Madaul22/Analog-Voltage-Stabilizer/Raport Proiect SCIA Madarasan.pdf

# Proiect SCIA

### Grupa : 2132

### Semigrupa : 1

### Student : Madarasan Ioan-Alexandru

# Cuprins

# 1.Tematica proiectului

### In procesarea analogica , drumul de la un semnal brut la o informatie utile este o calatorie a rafinamentului .Tematica acestui proiect vizeaza proiectarea si implementarea unui lant complet de conditionare , capabil sa transforme o unda

oscilanta intr-o tensiune stabila , optimizata pentru monitorizare si achzitie de date.

### Sistemul este construit in jurul a patru etaje , fiecare avand un rol in integritatea semnalului:

### -Pregatirea si Echilibrarea (Etajul 1) : Totul incepe cu Amplificatorul cu compensare DC . In aceasta etapa , semnalul nu este doar ridicat la un nivel

prelucrabil,ci si “curatat” de erorile de offset ,asigurand o baza de plecare simetrica si precisa pentru restul circuitului.

### -Selectia Spectrala (Etajul 2) : Semnalul trece apoi prin Filtru Trece-Banda

Rauch.Aceasta configuratie cu feedback multiplu actioneaza ca un selector riguros,

### lasand sa treaca doar banda de frecventa de interes si atenuand drastic atat zgomotul de joasa frecventa , cat si cel de inalta frecventa .Astfel, se obtine o “purificare”

spectrala necesara pentru o masuratoare corecta.

### -Adaptarea Dinamica (Etajul 3) : La etajul al treilea , sistemul capata inteliganta prin Amplificatorul cu Castig Programabil . Prin manevrarea manuala a rezistentelor de

feedback , utilizatorul poate ajusta sensibilitatea sistemului in 4 trepte cu pas de 3 dB , incepand de la 6dB pana la 15dB , oferind flexibilitate in fata unor semnale de intrare cu intensitati diverse.

### -Distilarea Finala (Etajul 4) : Drumul semnalului se incheie unde Redresorul de

precizie si Filtrul de integrare conlucreaza pentru a transforma oscilatiile purificate intr-

### o valoare medie constanta . Rezultatul este o tensiune DC liniara si perpendiculara , o

oglinda fidela a semnalului original , pregatita pentru interpretarea finala.

### Aceasta lucrare reprezinta o demonstratie a modului in care precizia matematica a simularii in LTSpice si provocarile reale ale implementarii pe breadboard converg

pentru a crea un instrument de masura fiabil.

# 2.Dimensionarea Etajelor

### 2.1.Etajul 1

### Specificatiile de proiectare a primului Etaj :

-tip sursa de semnal : sursa de tensiune ideala ; -Amplitudine minima (Vin_min) : 4.15E-01 V ;

-Amplitudine maxima(Vin_max) : 1.17E+00 V ;

-Tip etaj : Amplificator inversor cu 1 AO si compensare DC (2.1.1) ;

-Câștig liniar (|Av1
|) : 1.5;

-Amplificator operațional cerut : AD8065;

-Amplificator operațional utilizat : OP482 .

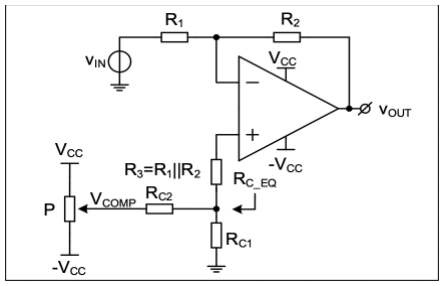
[picture p4: figure]

(2.1.1)

Realizarea calculelor:

1.Dimensionarea câștigului : Relația de transfer pentru un amplificator inversor este |Av1
| =

R2
R1

. Pentru a obține câștigul de specificat de 1.5 , alegem o

valoare standard pentru R1 care sa respecte impedanța de intrare si calculam R2 :

-Alegem R1 = 10kΩ ;

-Rezulta R2 = 1.5 ∙ R1 = 1.5 ∙ 10kΩ = 15kΩ.

2.Compensarea DC : Conform schemei de principiu , pentru a minimiza erorile de polarizare , se introduce rezistenta RC pe intrarea neinversoare :

- RC = R1

||R2 =

10kΩ∙15kΩ
10kΩ+15kΩ

= 6kΩ.

Pentru rețeaua de compensare a offset-ului , se vor alege valorile RC1

, RC2 si
potențiometrul P astfel încât curentul injectat sa poată compensa variațiile DC ale semnalului de intrare fără a afecta stabilitatea câștigului .

Pentru a asigura stabilitatea , am ales valorile de referința RC1=10kΩ si RC2 =10kΩ .

In cazul potențiometrului , am înlocuit componenta cu un divizor de tensiune realizat din 2 rezistente ambele având o valoare Rtot=10kΩ dar si un factor
poz =0.555 pentru a defini bratele divizorului:

-R3=Rtot ∙ poz = 10kΩ ∙ 0.555 = 5.55kΩ

-R4=Rtot ∙ (1-poz) = 10kΩ ∙ 0.455 = 4.45kΩ

2.2.Etajul 2

Specificațiile de proiectare pentru al doilea Etaj :

-Tip etaj : Band-pass 1 AO V-V Rauch (2.2.1);

-Câștig liniar in banda de trecere (|H0
|) : 1 ;
- Rezistenta de intrare minima (Rin_min) : 750 Ω ;

-Banda (BW) : 1000 Hz ;

-Factor de calitate (Q) : 0.707 ;

-Frecventa centrala (f0

) : Calculata cu BW ∙ Q = 707 Hz .

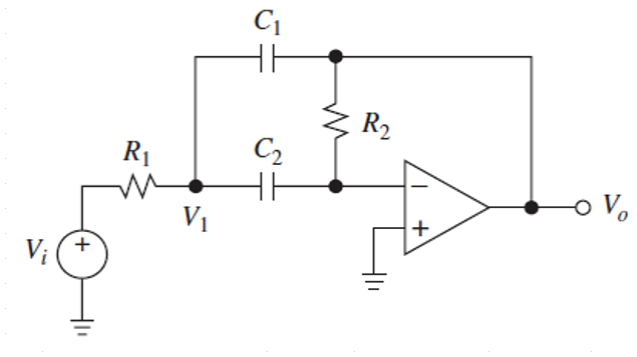
[picture p5: figure]

(2.2.1)

Realizarea calculelor :

Pentru proiectarea acestui filtru , utilizând relațiile specifice configurației Rauch (Multiple Feedback). Pentru a simplifica procesul si a asigura precizia , alegem o valoare pentru condensatoare : C1 = C2 = C = 100nF.

1.Calculul rezistentei R2

(Feedback) : Rezistenta R2 determina factorul de calitate si banda filtrului :

R2 =

Q
π∙f0∙C

=

1
π∙BW∙C

=

1
3.14∙1000∙100∙10⁻⁹ ≈ 3.18kΩ

2.Calculul rezistentei R1

(Intrare) : Rezistenta R1 seteaza castigul maxim |H0 |
la frecventa centrala :

R1 =

R2
2∙|H0|

=

3.18kΩ
2∙1

= 1.59kΩ

2.3.Etajul 3

Specificațiile de proiectare pentru al treilea Etaj:

-Tip etaj : Inversor cu switch-uri in calea de semnal , conexiune paralel;

-Câștig minim : 6 dB ;

-Câștig maxim : 15 dB ;

-Rezoluție (pas minim) : 3 dB ;

-Număr de pași : 4 (6 dB , 9 dB , 12 dB ,15dB);

-Rezistenta de intrare minima : 3kΩ .

Realizarea calculelor:

1.Alegerea rezistentei de intrare (Rg) : Pentru a respecta specificația de Rin_min alegem o valoare standard pentru Rg = 3.3kΩ .

2.Pasul de 15 dB(Câștig maxim – Switch S4 închis) : Pentru câștigul maxim , utilizam o singura rezistenta in bucla de reacție (R5
) .

Av(15dB) = 10¹⁵/20 ≈ 5.623

Recℎiv4 = Av(15dB)

- Rg = 5.623 ∙ 3.3kΩ = 18.55kΩ

Alegem R5 = 18.5kΩ

3.Pasul de 12 dB (Switch-urile S4,S3 închise) : Rezistenta echivalenta trebuie sa scadă pentru a reduce câștigul.

Av(12dB) = 10¹²/20 ≈ 3.98

Recℎiv3 = Av(12dB)

- Rg = 3.98 ∙ 3.3kΩ = 13.13kΩ

Deoarece Recℎiv3 = R5

||R4

, calculam R4
:

1
R4

=

1
13.13kΩ

−

1
18.5kΩ

⟹ R4 ≈ 45.2kΩ

Alegem o valoare standard : R4 = 47kΩ

4.Pasul de 9 dB(Switch-urile S4,S3,S2 închise) : Rezistenta echivalenta trebuie sa scadă pentru a reduce câștigul.

Av(9dB) = 10⁹/20 ≈ 2.818

Recℎiv3 = Av(9dB)

- Rg = 2.818 ∙ 3.3kΩ = 9.3kΩ

Deoarece Recℎiv2 = Recℎiv3

|| R3

,calculam R3
:

1
R3

=

1
13.13kΩ

−

1
9.3kΩ

⟹

R3 ≈ 33kΩ

Alegem o valoare standard : R3 = 33kΩ

4.Pasul de 6 dB(Switch-urile S4,S3,S2.S1 închise) : Rezistenta echivalenta trebuie sa scadă pentru a reduce câștigul.

Av(6dB) = 10⁶/20 ≈ 2

Recℎiv1 = Av(6dB)

- Rg = 2 ∙ 3.3kΩ = 6.6kΩ

Deoarece Recℎiv1 = Recℎiv2

|| R2

,calculam R2
:

1
R2

=

1
6.6kΩ

−

1
9.3kΩ

⟹ R2 ≈ 22.7kΩ

Alegem o valoare standard : R2 = 22kΩ

2.4.Etajul 4

Specificațiile de proiectare pentru al patrulea Etaj:

-Tip etaj : Redresor dublu alternanta (2.4.1) ;

-Câștig liniar (|Hv4
|) : 1 .

Realizarea calculelor si alegerea componentelor :

1.Pentru acest etaj ,s-au utilizat valorile nominale prevăzute in schema de proiectare pentru a asigura o redresare dubla alternanta simetrica si un câștig unitar.

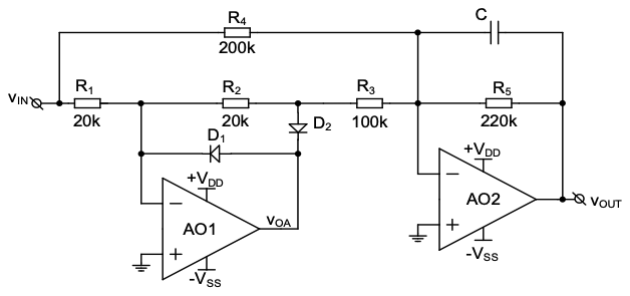
[picture p6: figure]

(2.4.1)

Lista valorilor pentru rezistente :

-R1 = 20kΩ ;

-R2 = 20kΩ ;

-R3 = 100kΩ ;

-R4 = 200kΩ ;

-R5 = 220kΩ .

2.Dimensionarea condensatorului de filtrare (C) : Aceasta este singura componenta dimensionata specific pentru a extrage valoarea medie (DC) a semnalului redresat.

S-a ales o constanta de timp τ = R · C mult mai mare decât perioada semnalului de intrare (T = 10 ms pentru 100Hz) .

Am ales valoarea condensatorului de C = 1µF . Împreuna cu rezistenta de feedback de 220kΩ , aceasta asigura o netezire eficienta , rezultând o tensiune continua stabila de aproximativ 700-900 mV la ieșire.

## 3.Caracterizarea Etajelor

In cadrul parții de simulare a proiectului am utilizat programul de simulare LTspice . In acest program am realizat toate schemele electrice si pofilele de simulare pentru fiecare dintre etaje .

3.1.Etajul 1

Pornind de la schema de principiu primita in specificații , am realizat aceasta schema :

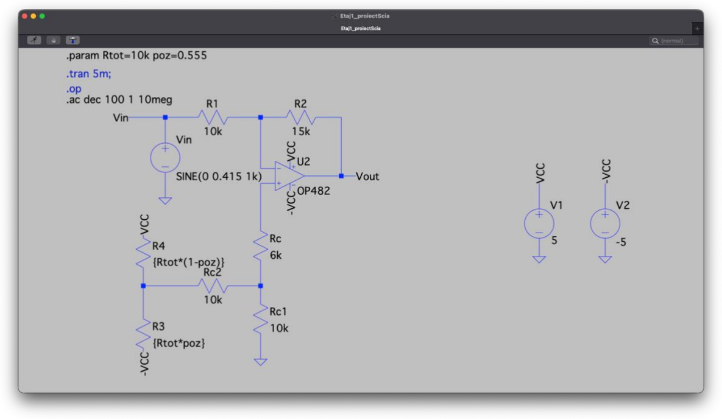
[picture p7: figure]

In cadrul aceste scheme putem observa următoarele lucruri:

-secvența „.param Rtot =10k poz=0.555” semnifica instantierea in programul de simulare a parametrilor „Rtot” si „poz” care sunt necesari pentru realizarea divizorului de tensiune pentru compensarea DC a circuitului ;

-secvența „.op” semnifica o simulare de tip DCOP pentru afișarea punctului static de funcționare a circuitului ;

-secvența „.tran 5m” semnifica o simulare de tip Transient cu ajutorul căreia v-om putea măsura Slew-Rate-ul amplificatorului , cat si sa demonstram liniaritate si compensarea DC ;

-secvența „.ac dec 100 1 10meg” semnifica o simulare tip .AC cu ajutorul căreia v-om putea analiza castigul la joasa freceventa cat si banda de frecventa .

Primul profil de simulare pe care il v-om aborda este cel de tip DCOP . In imaginea de mai jos putem vedea fereasta care se poate acesa dupa rularea simularii de tip „.op”.

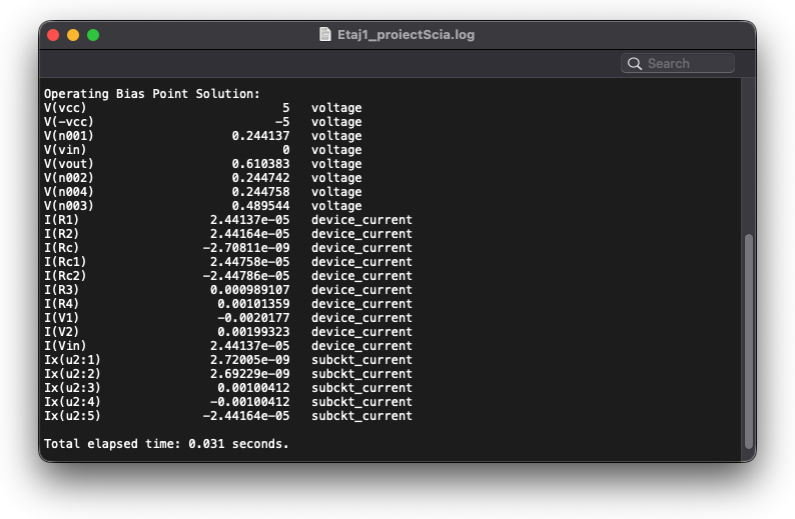
[picture p8: figure]

In cadrul imagini de mai sus putem identifica următoarele valori , pentru determinarea punctului static de funcționare cat si compensarea DC ,precum :

-V(vout) = 610mV , aceasta fiind Tensiunea de ieșire in repaus. Aceasta nu este 0 deoarece reflecta tensiunea de offset injectata prin rețeaua de compensare de la intrarea neinversoare;

-Curenții de polarizare prin ramurile rezistive :

-I(R1
) =24.41µA , curentul care trece prin rezistenta de intrare când Vin este la masa;

-I(R2
)=24.41µA , curentul prin rezistenta de feedback. Faptul ca acești doi curenți sunt identici confirma ca AO , nu „pierde” curent prin intrările sale , prezentând un caracter ideal.

Al doilea profil de simulare este cel de Analiza in frecventa(AC Analysis) care ne arata performantele etajului de amplificare si compensare DC , demonstrând o lățime de banda considerabila , mult peste frecventa semnalului util.

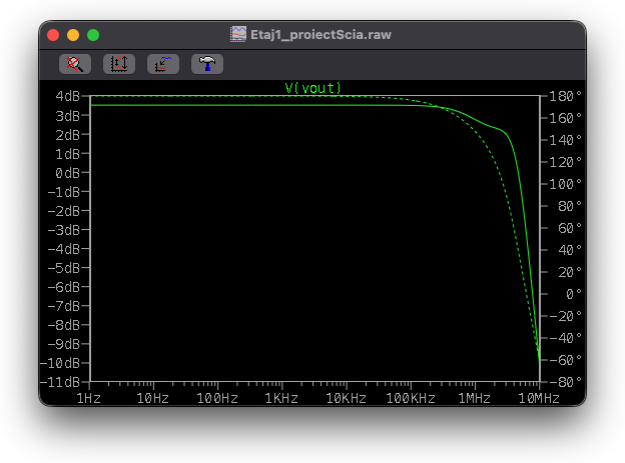
[picture p9: figure]

Câștigul de banda se observa s pe graficul de mai sus , o linie orizontala constanta la valoarea de 3.52 dB . Aceasta corespunde exact câștigului liniar calculat de 1.5 (20log(1.5)≈ 3.522 dB) , validând corectitudinea dimensionării rezistentelor R1 si R2

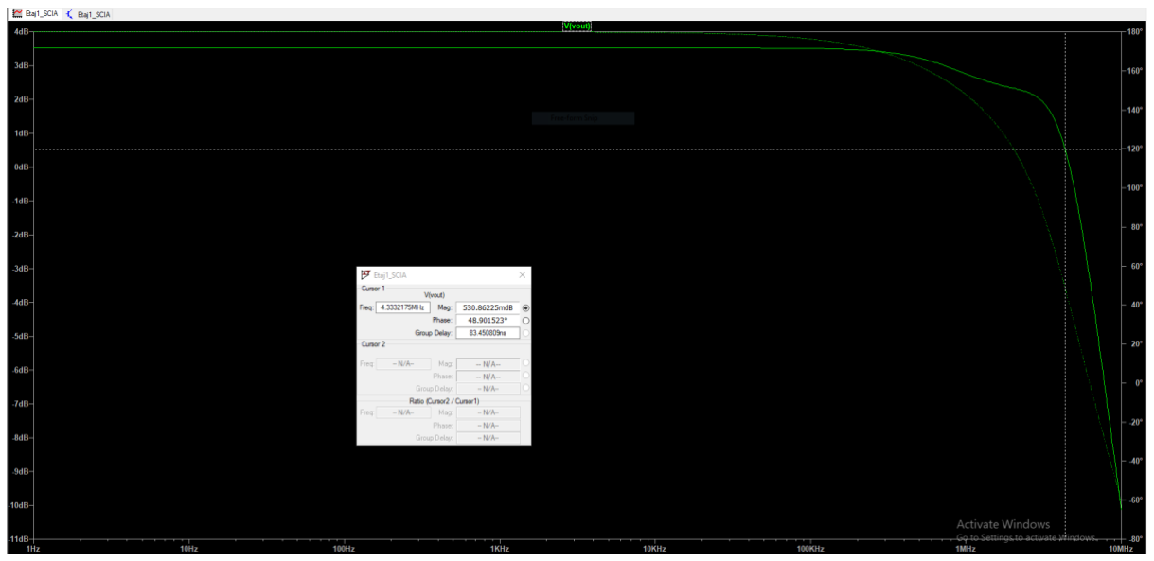
[picture p10: figure]

In cadrul lățimii de banda se poate observa frecventa de taiere la -3dB se situează in jurul valorii de 4.3MHz. Acest rezultat garantează ca etajul 1 procesează fără nicio atenuare sau defazaj suplimentar in banda filtrului de la etajul următor, asigurând integritatea semnalului pentru etajele următoare.

Al treilea si ultimul profil de simulare al acestui etaj este cel Transient ,in care v-om analiza compensarea DC, cat si v-om studia liniaritatea.

Spre deosebire de intrare , care este centrata la 0V , semnalul de ieșire este translatat pe verticala . Se observa ca valorile de vârf ale ieșirii sunt aproximativ la +1.23V si 0V . Media semnalului (offset-ul DC) este situata la aproximativ 0.61V , valoarea care corespunde exact rezultatului simulării „.op”.

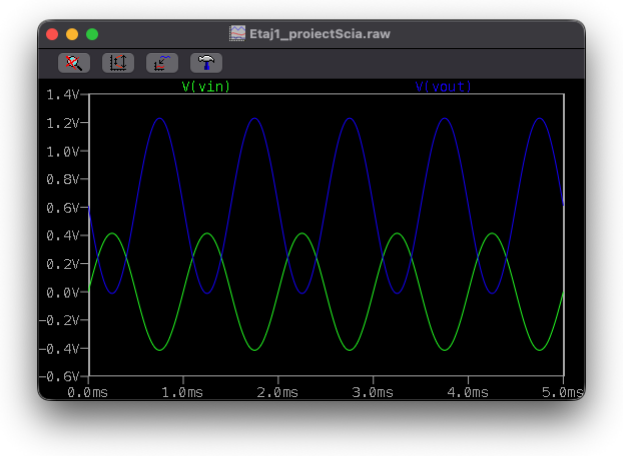
[picture p11: figure]

In imaginea de mai jos sa poate observa Slew-Rate-ul circuitului:

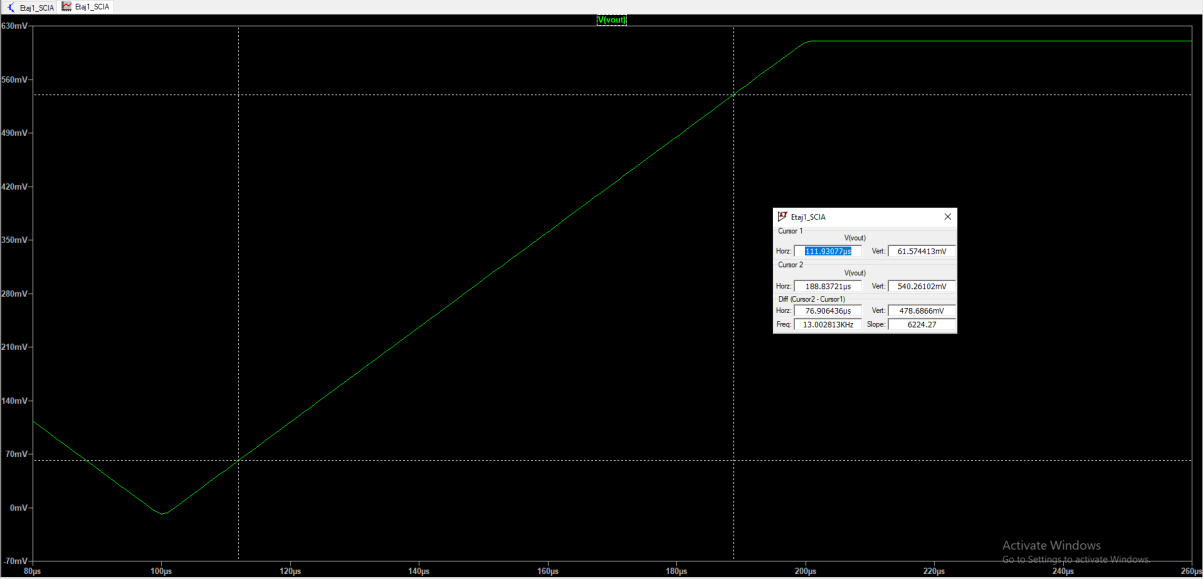
[picture p12: figure]

3.2. Etajul 2

Pornind de la schema de principiu primita in specificații , am realizat aceasta schema :

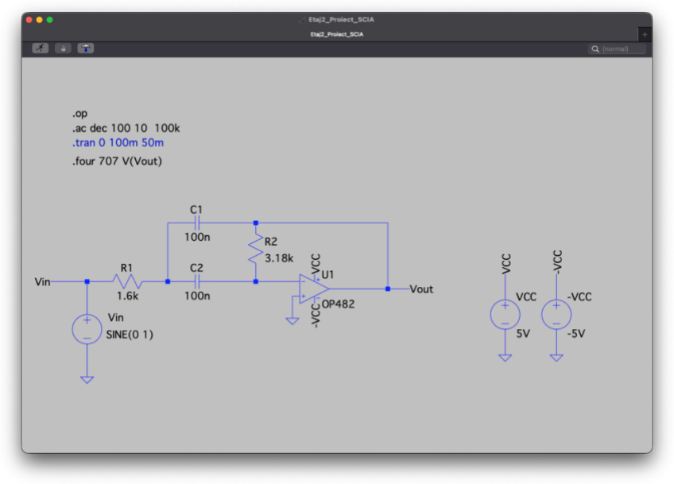
[picture p13: figure]

In cadrul acestei scheme putem observa următoarele lucruri :

-secvența „.op” semnifica o simulare de tip DCOP pentru afișarea punctului static de funcționare a circuitului ;

-secvența „.ac dec 100 10 100k” semnifica o simulare tip .AC cu ajutorul căreia v-om putea analiza câștigul la joasa frecventa cat si banda de frecventa .

-secvențele „.tran 0 100m 50m” si „.four 707 V(Vout)” , unde secventa .tran are rol de simulare principala iar .four este o analiza Fourier care ne arata valorea TDH-ului pentru filtrul Trece-Banda Rauch .

Primul profil de simulare pe care il v-om aborda este cel de tip DCOP . In imaginea de mai jos putem vedea fereasta care se poate accesa dupa rularea simularii de tip „.op”.

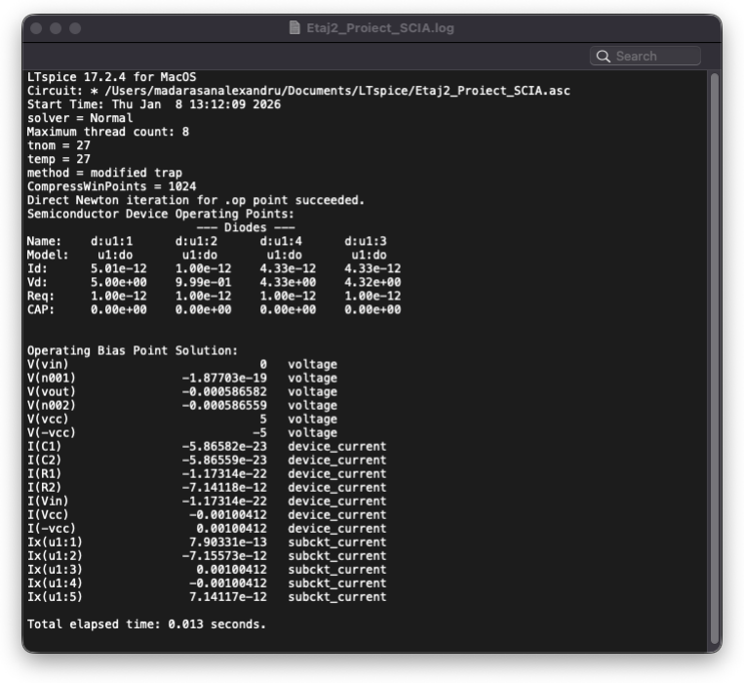
[picture p14: figure]

In cadrul imagini de mai sus putem identifica următoarele valori , pentru determinarea punctului static de funcționare :

-tensiunea de iesire in repaus (VOut2
) : Valoare este de aproximativ 1.81nV (aproape de 0V);

-curentii prin condensatoare ( I(C1) , I(C2) ) : Valorile sunt de ordinul 10⁻²⁰A;

Al doilea profil de simulare pe care il v-om aborda este cel de Analiza in frecventa . In imaginea de mai jos putem vedea graficul rezultat simulari noastre si putem analiza urmatoarele aspecte :

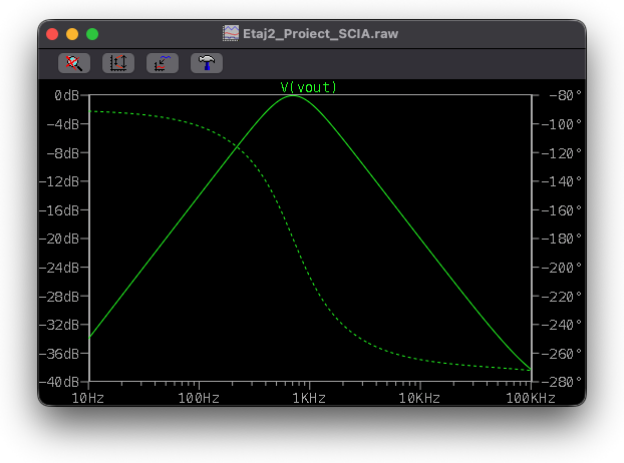
[picture p15: figure]

-din analiza graficului de magnitudine ( curba continua ) , se observa ca valoarea maxima a câștigului se obține la frecventa de rezonanta;

-valoarea măsurata a câștigului in banda este de 0 dB , ceea ce corespunde unui raport liniar de 1 . Aceasta valoare confirma ca etajul de filtrare asigura transferul semnalului util către etajul următor fără atenuări excesive care ar putea degrada raportul semnal-zgomot.

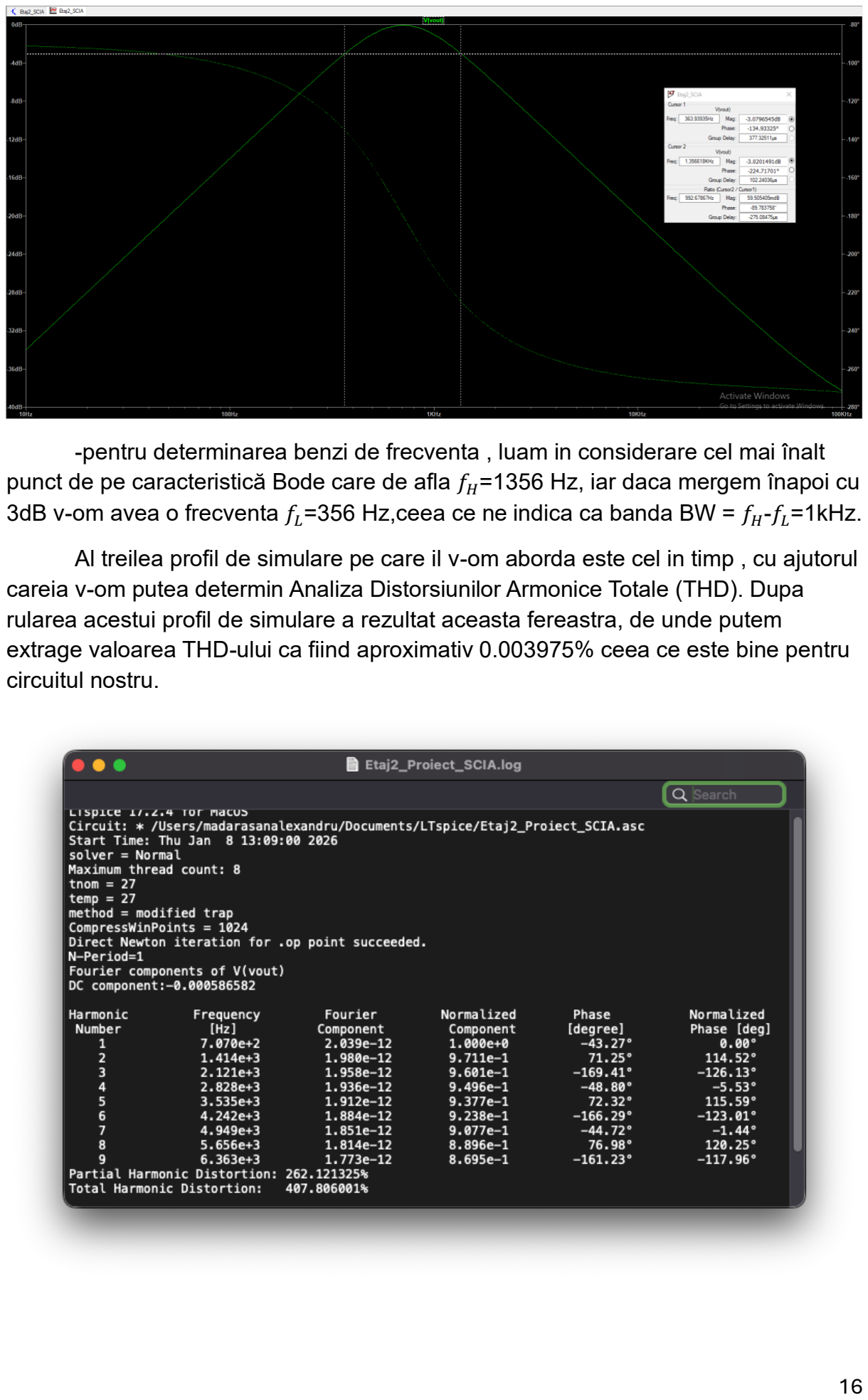
[picture p16: page 16]

-pentru determinarea benzi de frecventa , luam in considerare cel mai înalt punct de pe caracteristică Bode care de afla fH=1356 Hz, iar daca mergem înapoi cu 3dB v-om avea o frecventa fL=356 Hz,ceea ce ne indica ca banda BW = fH-fL=1kHz.

Al treilea profil de simulare pe care il v-om aborda este cel in timp , cu ajutorul careia v-om putea determin Analiza Distorsiunilor Armonice Totale (THD). Dupa rularea acestui profil de simulare a rezultat aceasta fereastra, de unde putem extrage valoarea THD-ului ca fiind aproximativ 0.003975% ceea ce este bine pentru circuitul nostru.

3.3.Etajul 3

Pornind de la schema de principiu primita in specificații , am realizat aceasta schema :

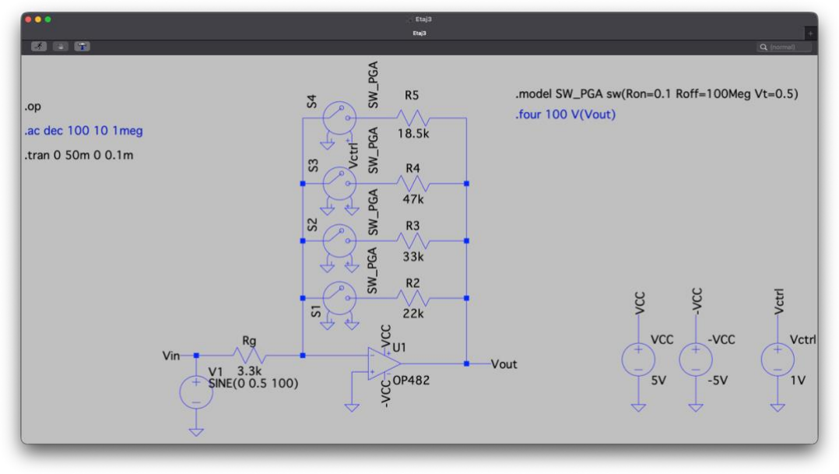
[picture p17: figure]

In cadrul aceste scheme , putem sa analizam cate va lucruri:

-secvența „.op” care este specifica unui profil de simulare DCOP , cu ajutorul căreia v-om putea determina punctul static de funcționare ( PSF );

-secvența „.ac dec 100 10 1meg” care reprezintă profil de simulare pentru Analiza in frecventa , cu ajutorul căreia v-om putea arata câștigul pe fiecare treapta cat si banda acestora ;

-secvențele „.tran 0 50m 0 0.1m” si „.four 100 V(Vout)” ambele fac parte pentru simulare in timp cu ajutorul căreia v-om putea determina THD-ul circuitului atât pentru câștig maxim (15dB) cat si la câștig minim (6dB).

Primul profil de simulare pe care ii v-om aborda este cel de tip DCOP . In imaginea de mai jos putem vedea fereastra care se poate accesa după rularea simulării de tip „.op”.

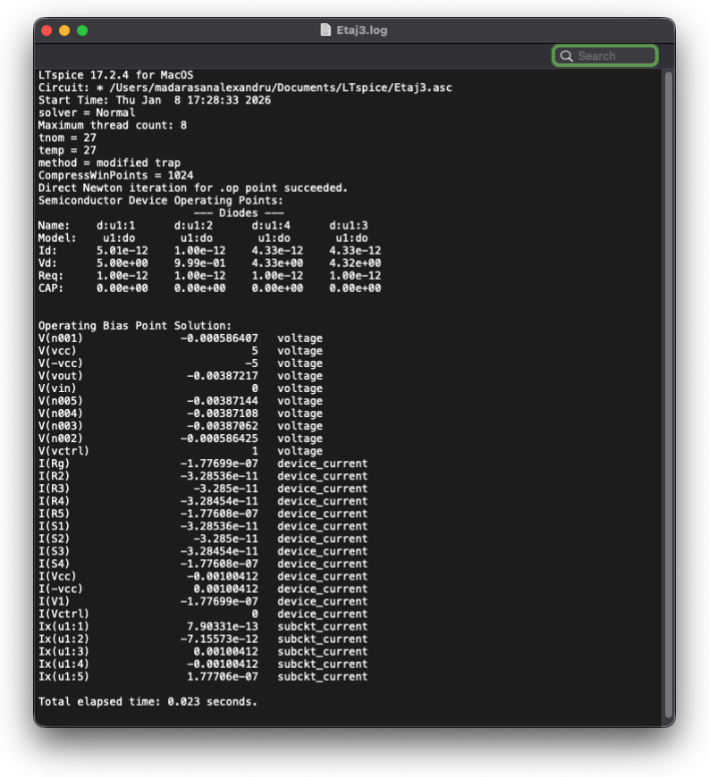
[picture p18: figure]

In cadrul imagini de mai sus putem identifica următoarele valori , pentru determinarea punctului static de funcționare :

-tensiunea de iesire in repaus (VOut2
) : Valoare este de aproximativ 1.81nV (aproape de 0V);

Al doilea profil de simulare pe care il v-om aborda este cel de Analiza in frecventa , prin acest profil de simulare o sa putem analiza castigul fiecarei trepte:

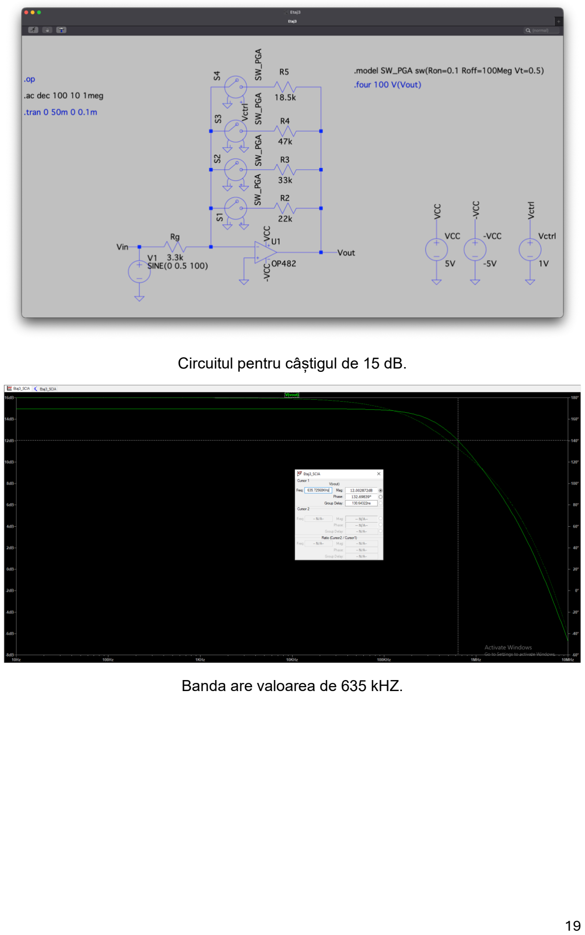
[picture p19: page 19]

Circuitul pentru câștigul de 15 dB.

Banda are valoarea de 635 kHZ.

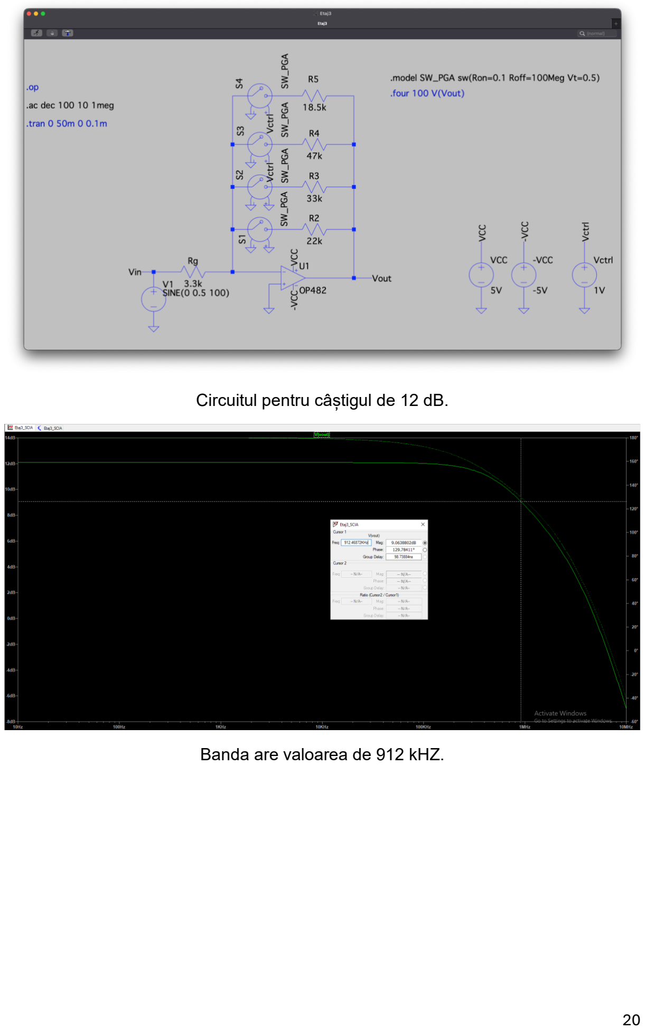
[picture p20: page 20]

Circuitul pentru câștigul de 12 dB.

Banda are valoarea de 912 kHZ.

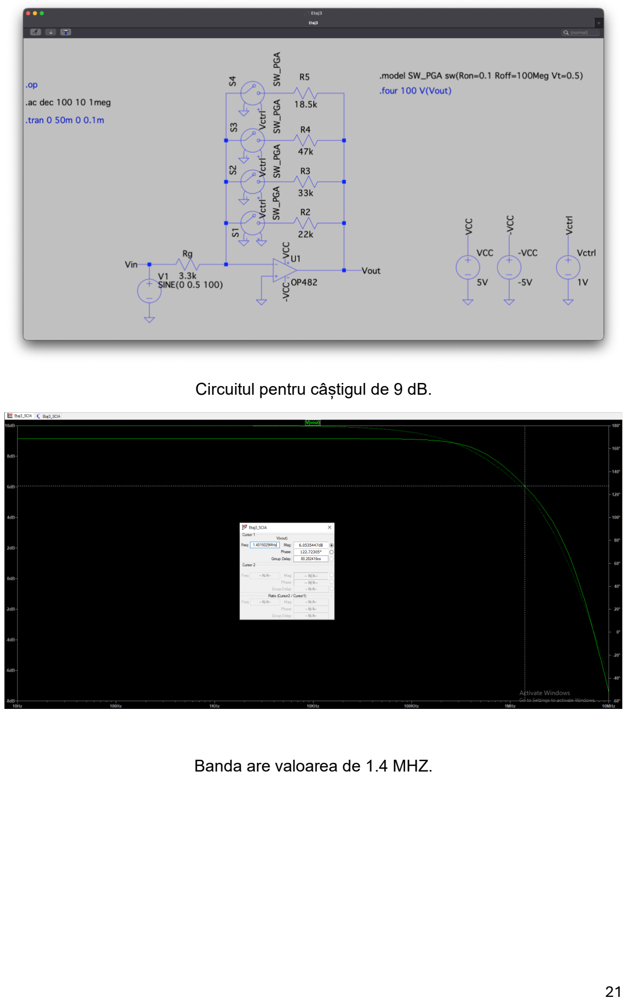
[picture p21: page 21]

Circuitul pentru câștigul de 9 dB.

Banda are valoarea de 1.4 MHZ.

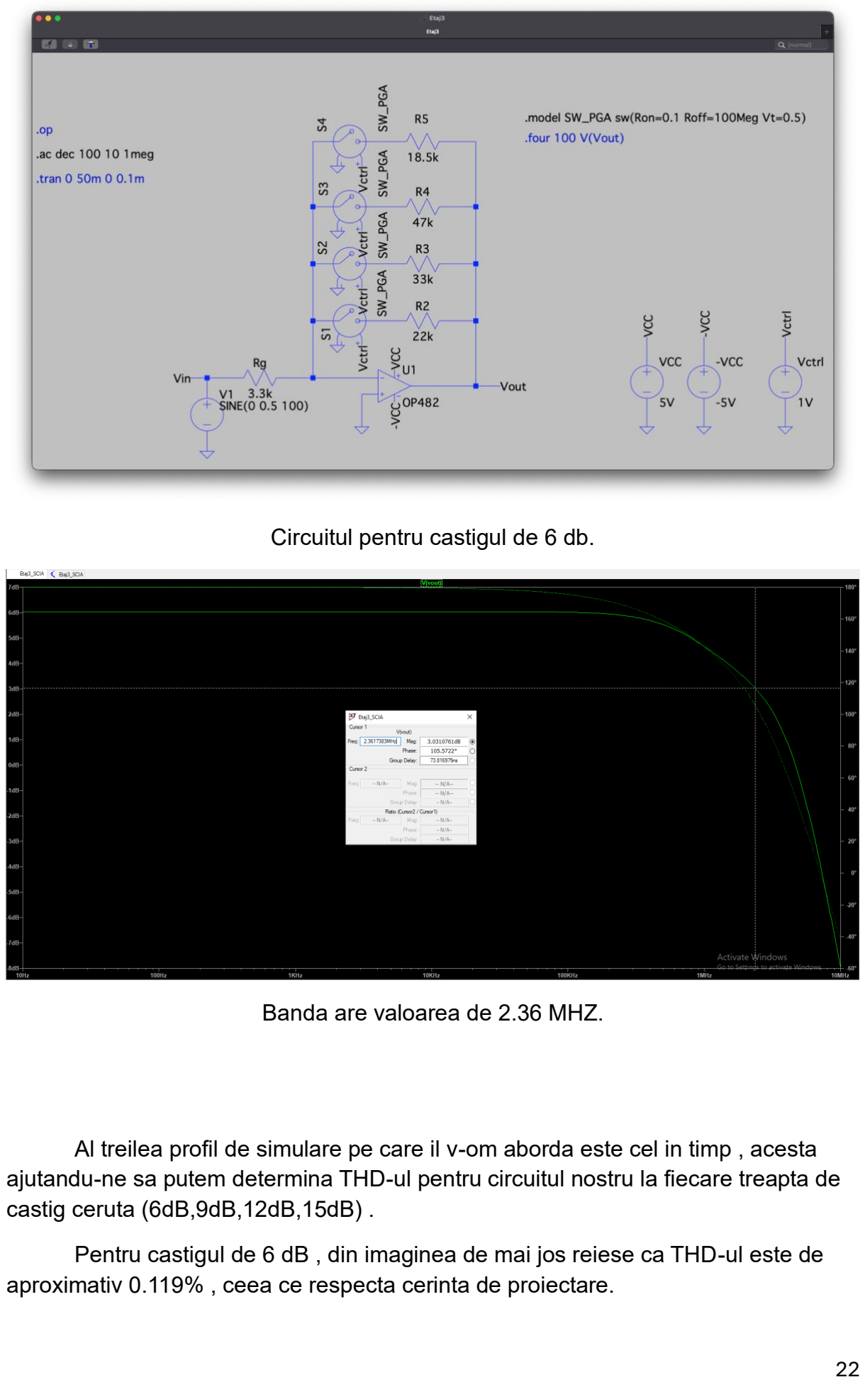
[picture p22: page 22]

Circuitul pentru castigul de 6 db.

Banda are valoarea de 2.36 MHZ.

Al treilea profil de simulare pe care il v-om aborda este cel in timp , acesta ajutandu-ne sa putem determina THD-ul pentru circuitul nostru la fiecare treapta de castig ceruta (6dB,9dB,12dB,15dB) .

Pentru castigul de 6 dB , din imaginea de mai jos reiese ca THD-ul este de aproximativ 0.119% , ceea ce respecta cerinta de proiectare.

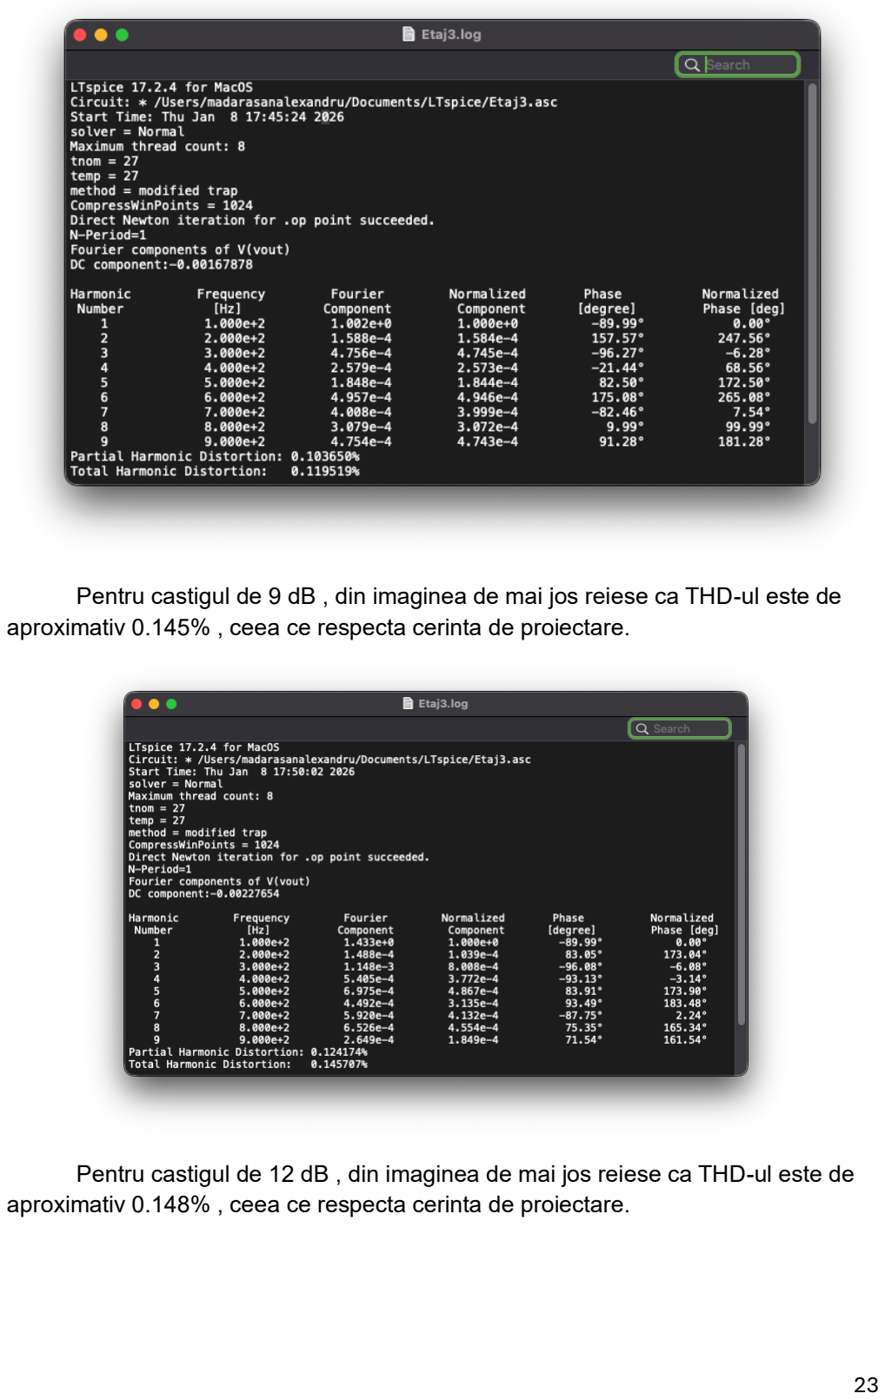
[picture p23: page 23]

Pentru castigul de 9 dB , din imaginea de mai jos reiese ca THD-ul este de aproximativ 0.145% , ceea ce respecta cerinta de proiectare.

Pentru castigul de 12 dB , din imaginea de mai jos reiese ca THD-ul este de aproximativ 0.148% , ceea ce respecta cerinta de proiectare.

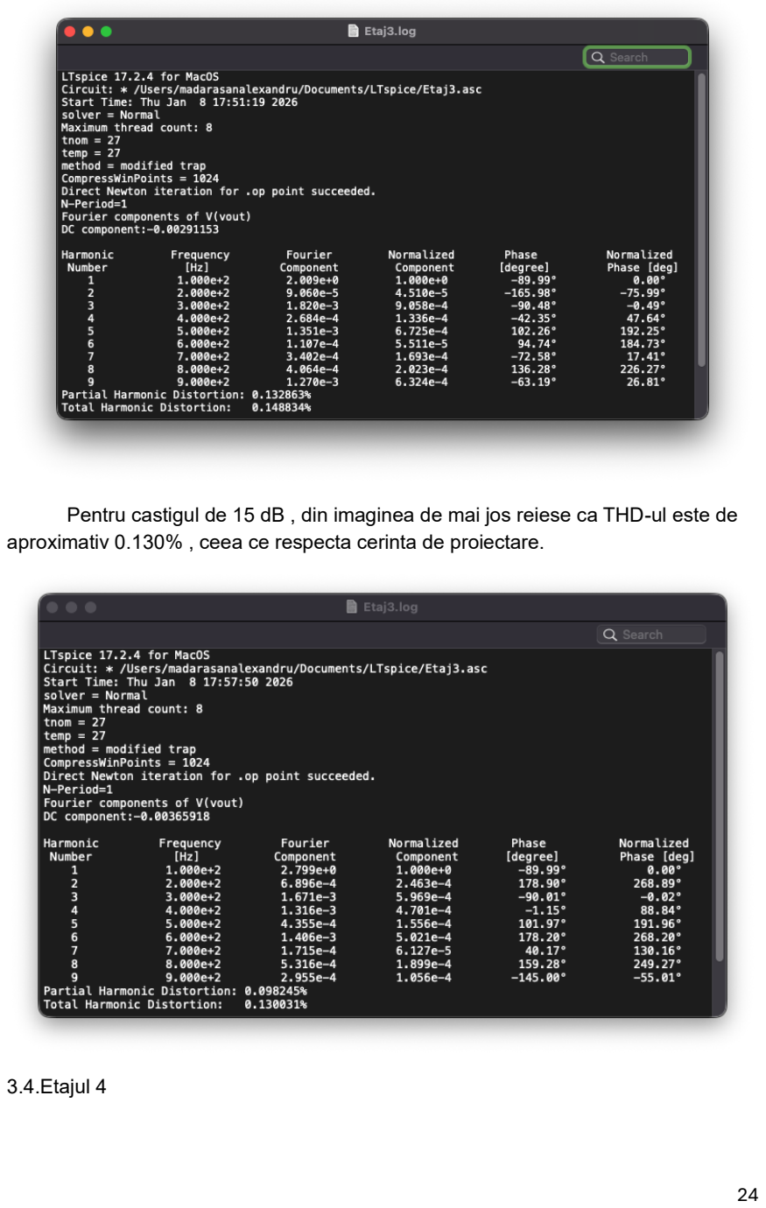
[picture p24: page 24]

Pentru castigul de 15 dB , din imaginea de mai jos reiese ca THD-ul este de aproximativ 0.130% , ceea ce respecta cerinta de proiectare.

3.4.Etajul 4

Pornind de la schema de principiu primita in specificații , am realizat aceasta schema :

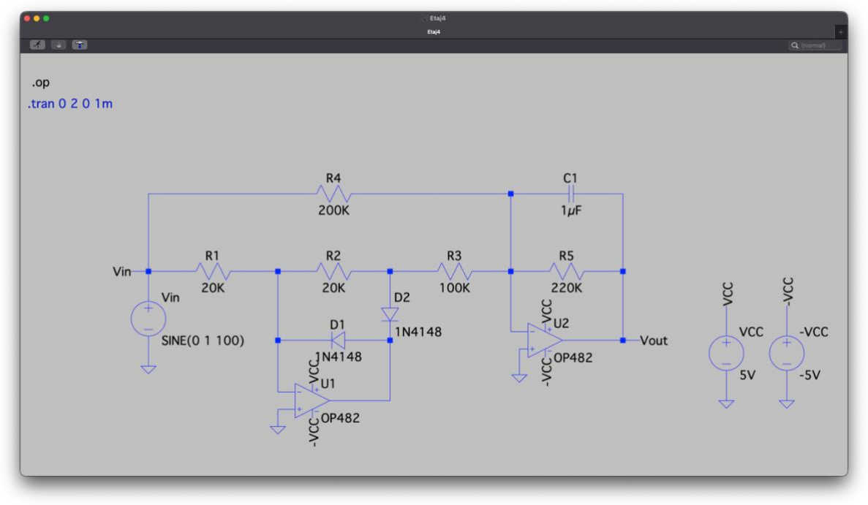
[picture p25: figure]

In cadrul aceste scheme , putem sa analizam cate va lucruri:

-secvența „.op” care este specifica unui profil de simulare DCOP , cu ajutorul căreia v-om putea determina punctul static de funcționare ( PSF );

-secvența „.tran 0 2 0 1m” care este specifica unu profil de simulare in timp , cu ajutorul căreia v-om putea arata domeniul de funcționare cat si implementarea funcției de circuit ;

In următorul circuit au fost făcute anumite modificări pentru a putea realiza profil de simulare DC Sweep , cu ajutorul căreia v-om putea vizualiza câștigul circuitului.

In cadrul acestei imagini se poate observa secvența „.dc Vin -2 2 0.01”.

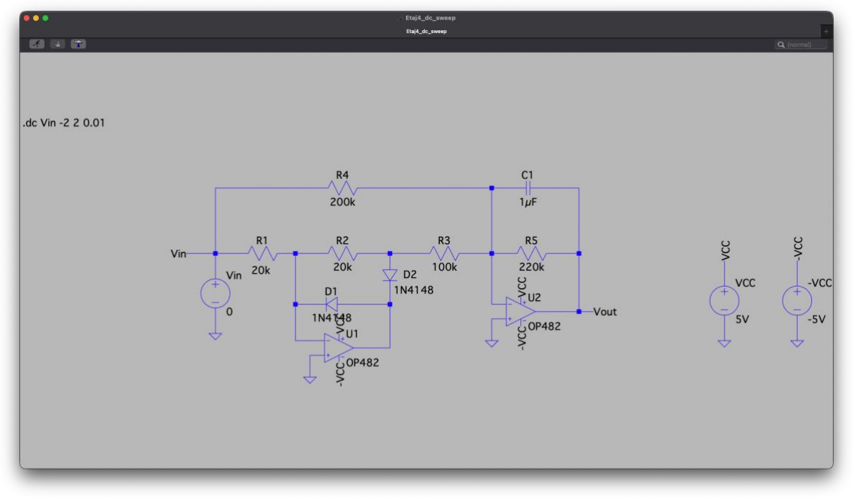
[picture p26: figure]

Primul profil de simulare pe care ii v-om aborda este cel de tip DCOP . In imaginea de mai jos putem vedea fereastra care se poate accesa după rularea simulării de tip „.op”.(3.4.1)

In cadrul imagini de mai jos putem identifica următoarele valori , pentru determinarea punctului static de funcționare :

-tensiunea de ieșire in repaus (VOut2
) : Valoare este de aproximativ 1.81nV (aproape de 0V);

-curenții prin condensatoare ( I(C1) ) : Valorile sunt de ordinul 10⁻²⁰A;

Al doilea profil de simulare pe il v-om aborda este de de tip DC Sweep . In imaginea de mai jos putem oberva evolutia castigului , realizand o forma de „V” specifica acestui redresor.

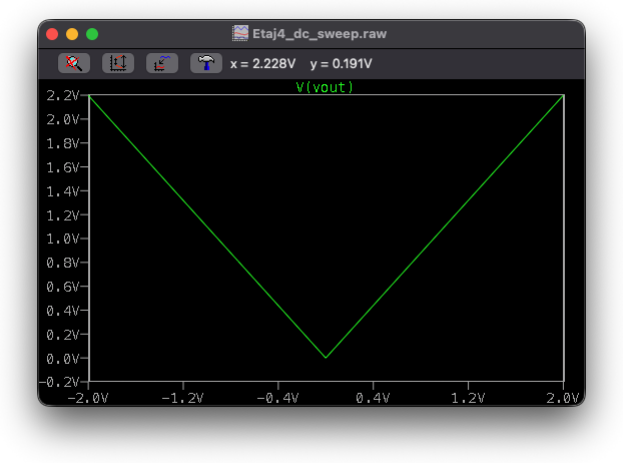
[picture p27: figure]

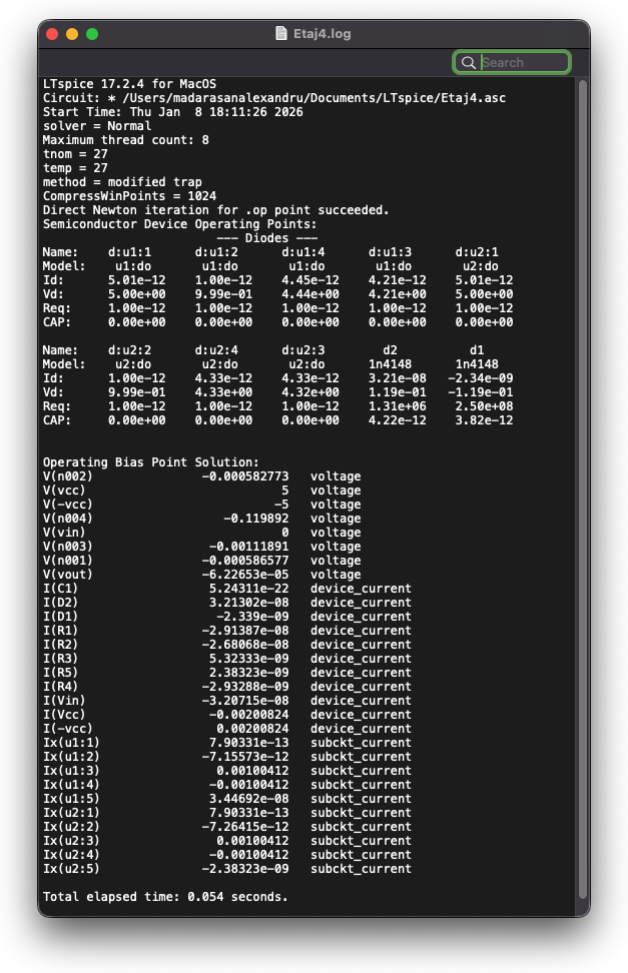
[picture p28: figure]

(3.4.1)

Al treilea profil de simulare pe care il v-om aborda este cel in timp , acesta ne v-a ajuta sa verificam daca cirucuitul de redresare isi face treaba si la iesire vedem cum vedem un semnal care la final de stabilizeaza si devine un semnal DC din sinusul aplicat la intrare din etajele anterioare.

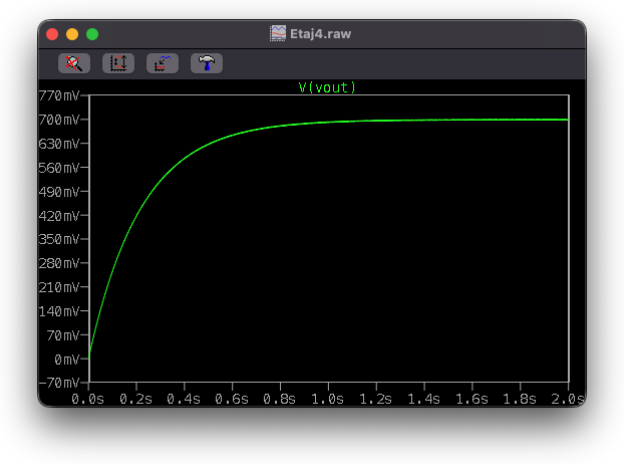
[picture p29: figure]

# 4.Verificarea si caracterizarea interfetei analogice

In cadrul acestui capitol o sa facem tranziția de la un domeniu ideal(simulări) la un domeniu real (circuite realizate pe breadboard) , unde o sa observam ca fata de simulări o sa întâmpinam mici diferențe .

4.1.Etajul 1

In cadrul acestui etaj am realizat circuitul pe breadboard , cu ajutorul componentelor puse la dispoziție de către facultate , in cele din urma am conectat cu succes dispozitivul ADALM2000 iar împreuna cu programul dedicat acestuia numit Scopy , am reușit sa realizeze măsurătorile cerute pentru acest etaj așa cum se poate vedea si in capturile de ecran .

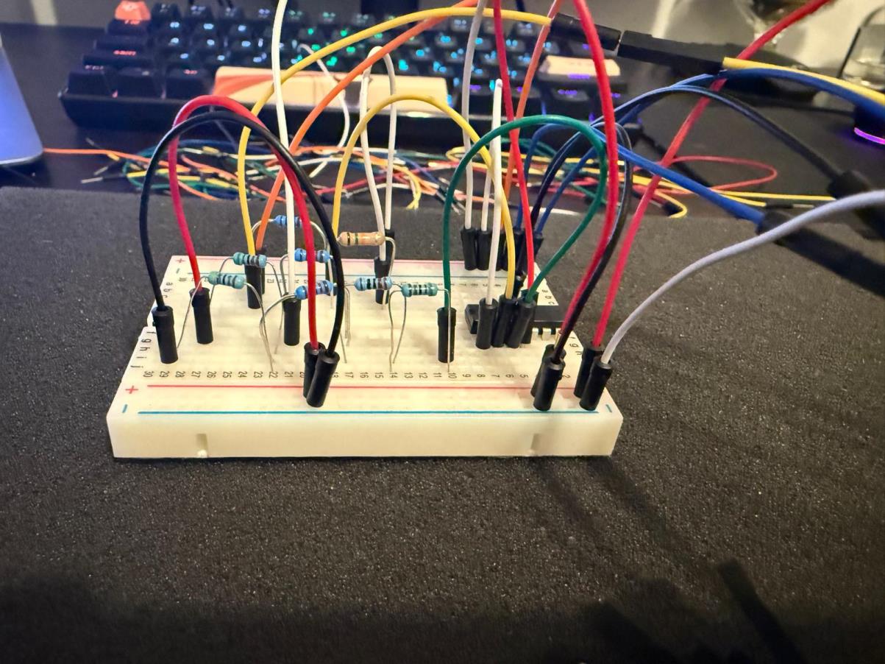
[picture p30: figure]

Circuitul fizic pentru Etajul 1

In cadrul masuratorilor am realizat masurarea Slew-Rate-ului amplificatorului utilizat , asa cum se poate vedea in imagine urmatoare:

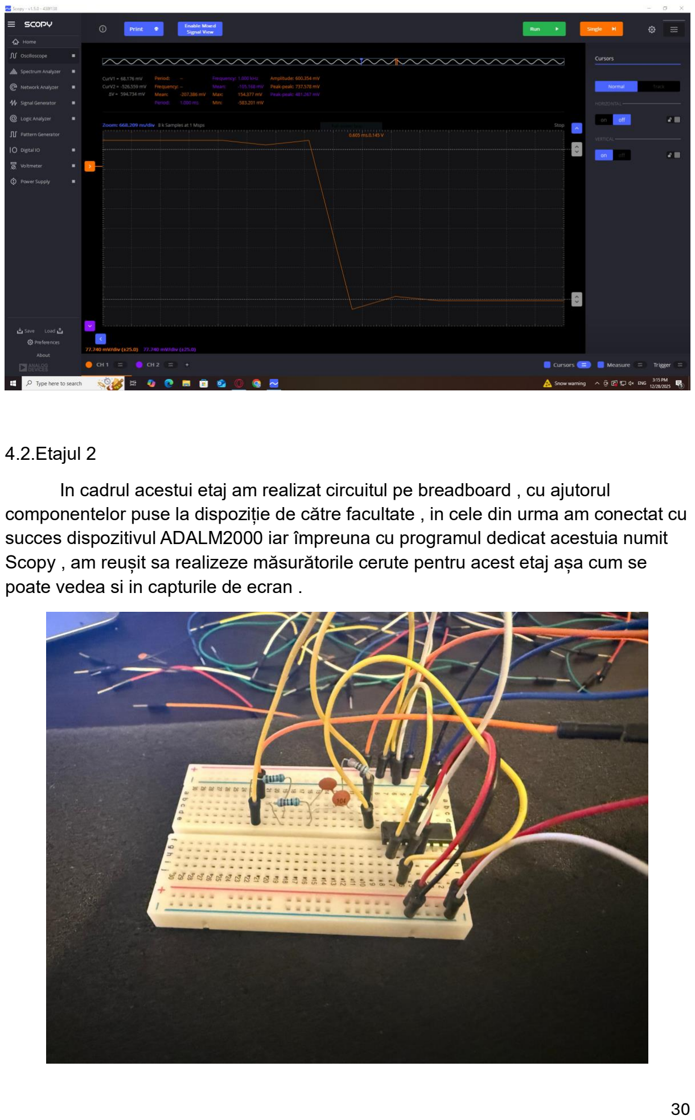
[picture p31: page 30]

4.2.Etajul 2

In cadrul acestui etaj am realizat circuitul pe breadboard , cu ajutorul componentelor puse la dispoziție de către facultate , in cele din urma am conectat cu succes dispozitivul ADALM2000 iar împreuna cu programul dedicat acestuia numit Scopy , am reușit sa realizeze măsurătorile cerute pentru acest etaj așa cum se poate vedea si in capturile de ecran .

In ceea ce priveste partea de masuratori fizice , pentru acest etaj de filtrare am realizat masurarea castigului cat si masurarea benzii de trecere .

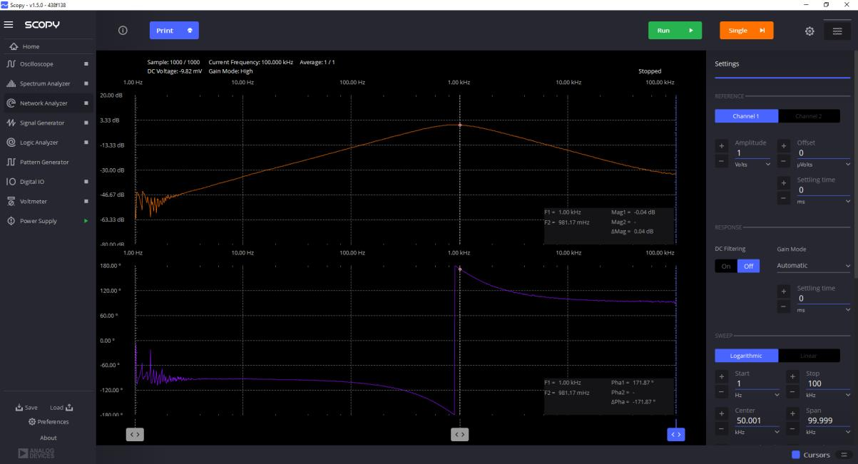
[picture p32: figure]

Imagine din programul Scopy pentru măsurarea câștigului care este 0 dB, ce corespunde in liniaritate cu câștigul de 1 din specificații.

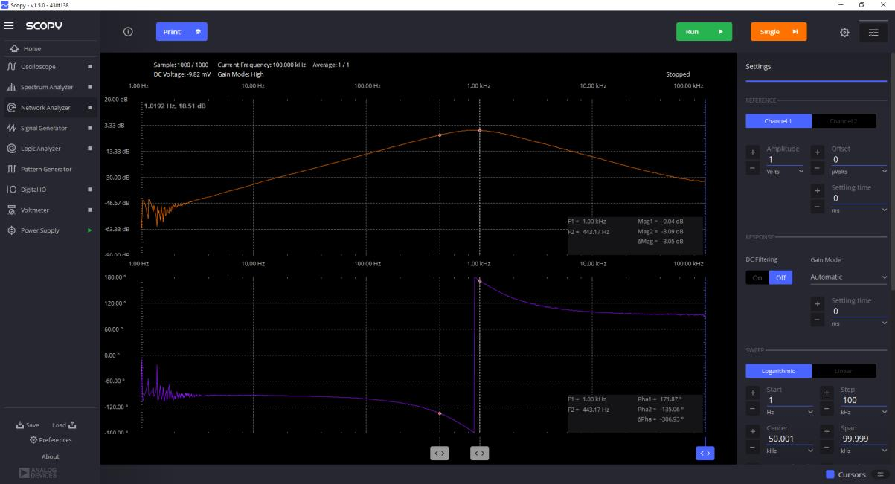
[picture p33: figure]

In imaginea anterioara extrasa din programul Scopi , se poate observa procesul de masurare a benzii de transfer cu ajutor celor 2 cursoare care unu este positionat pe varful „clopotului” iar celalat este pozitionat la -3 dB fata de pozitia din varf. Banda masurata este conform celor din specificatii.

4.3.Etajul 3

In cadrul acestui etaj am realizat circuitul pe breadboard , cu ajutorul componentelor puse la dispoziție de către facultate , in cele din urma am conectat cu succes dispozitivul ADALM2000 iar împreuna cu programul dedicat acestuia numit Scopy , am reușit sa realizeze măsurătorile cerute pentru acest etaj așa cum se poate vedea si in capturile de ecran .

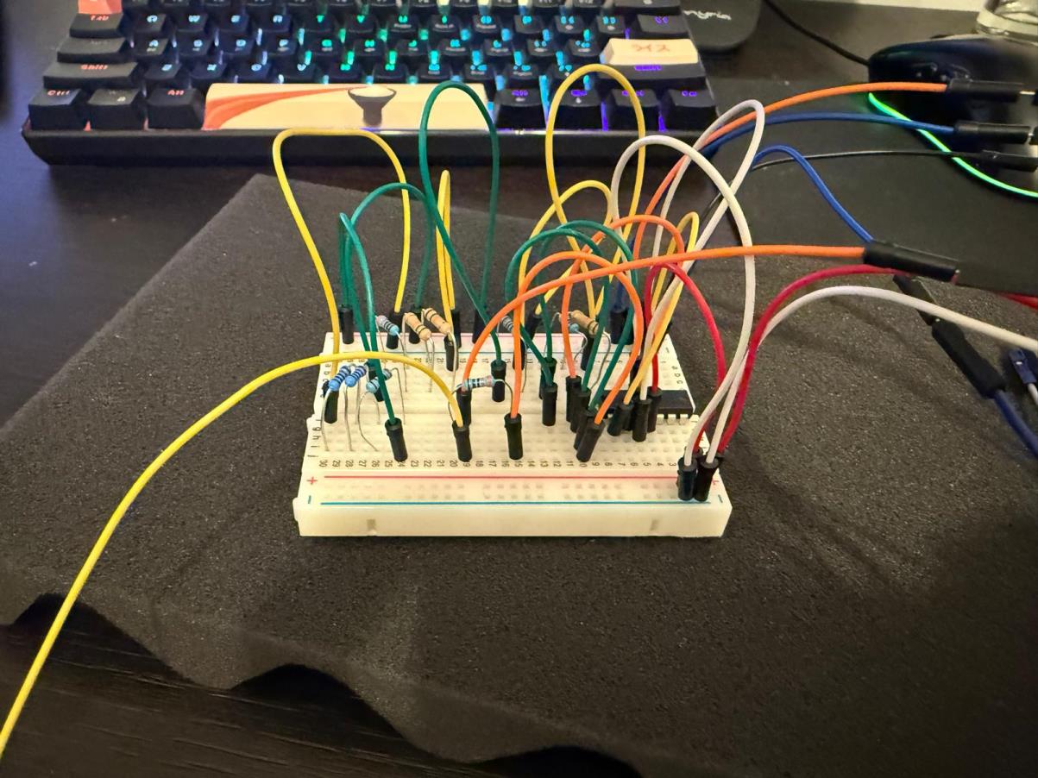
[picture p34: figure]

In cadrul acestui etaj am realizat măsurarea câștigului si măsurarea benzii de trecere pentru fiecare treapta a circuitului (6dB,9dB,12dB,15dB).

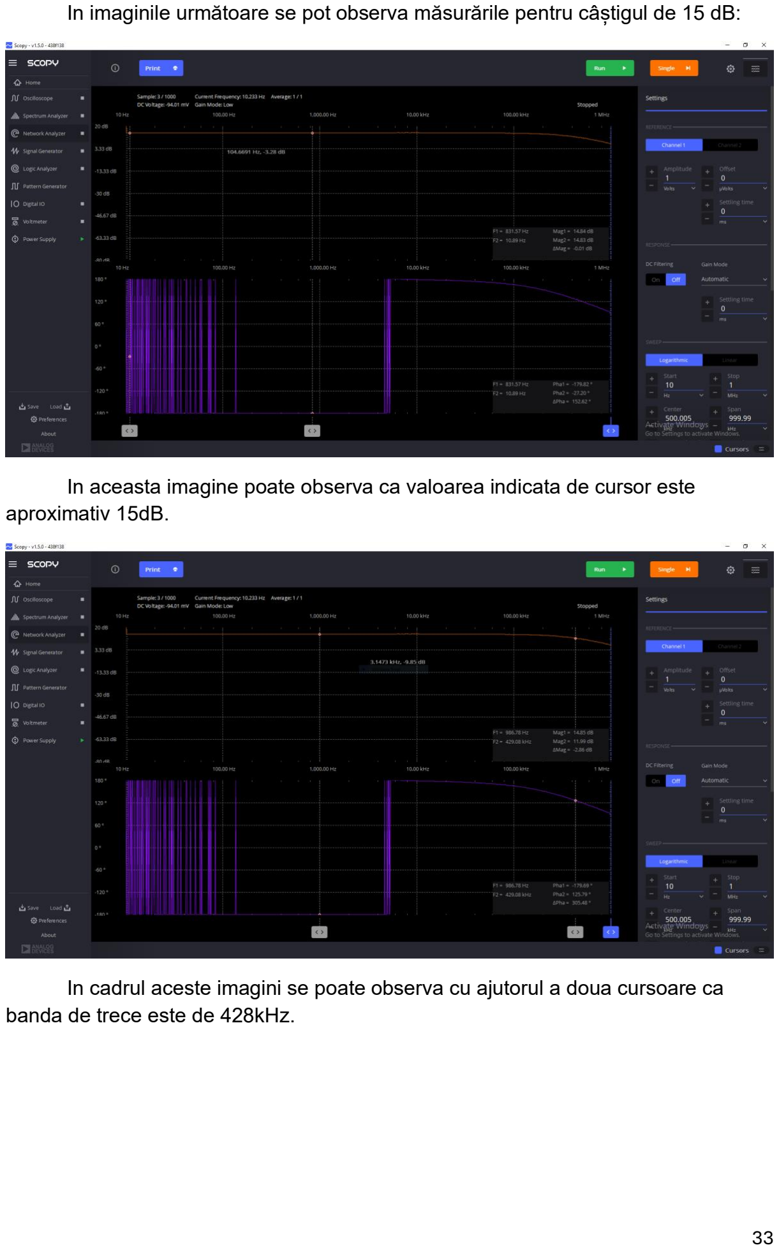
[picture p35: page 33]

In imaginile următoare se pot observa măsurările pentru câștigul de 15 dB:

In aceasta imagine poate observa ca valoarea indicata de cursor este aproximativ 15dB.

In cadrul aceste imagini se poate observa cu ajutorul a doua cursoare ca banda de trece este de 428kHz.

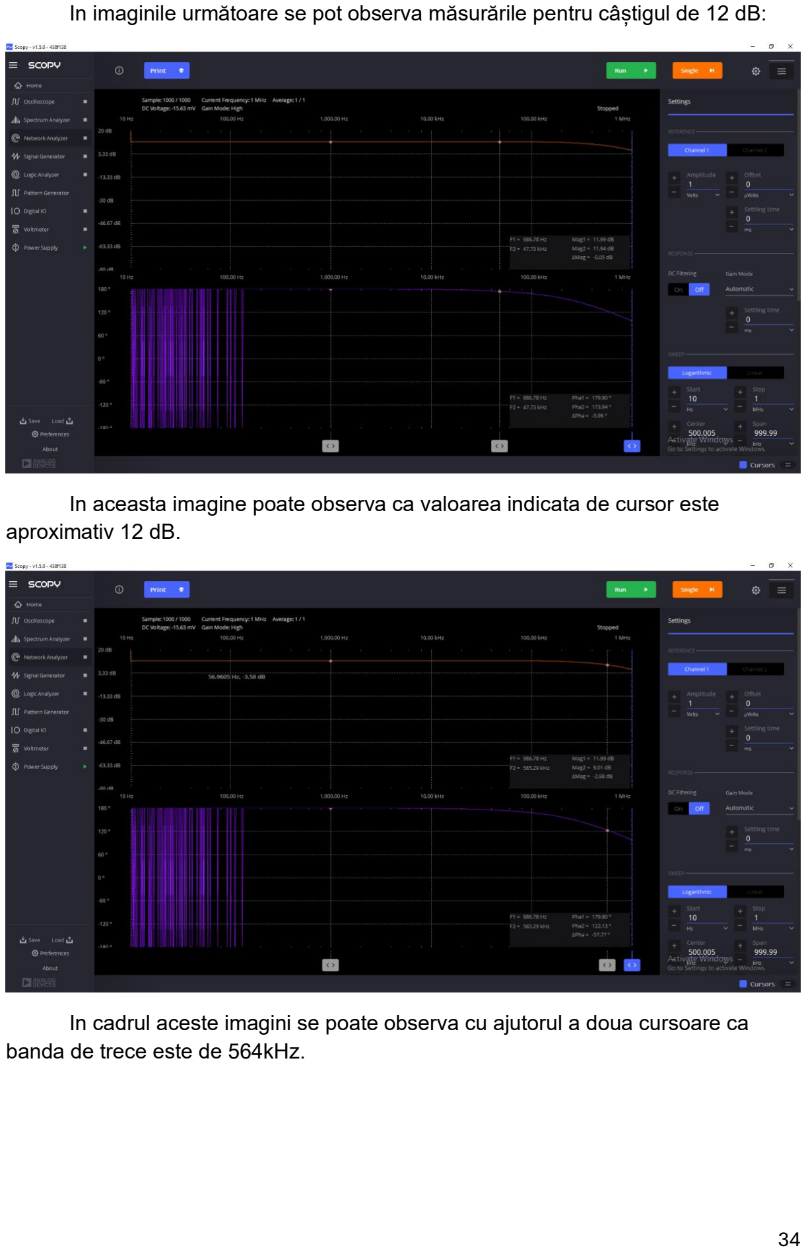
[picture p36: page 34]

In imaginile următoare se pot observa măsurările pentru câștigul de 12 dB:

In aceasta imagine poate observa ca valoarea indicata de cursor este aproximativ 12 dB.

In cadrul aceste imagini se poate observa cu ajutorul a doua cursoare ca banda de trece este de 564kHz.

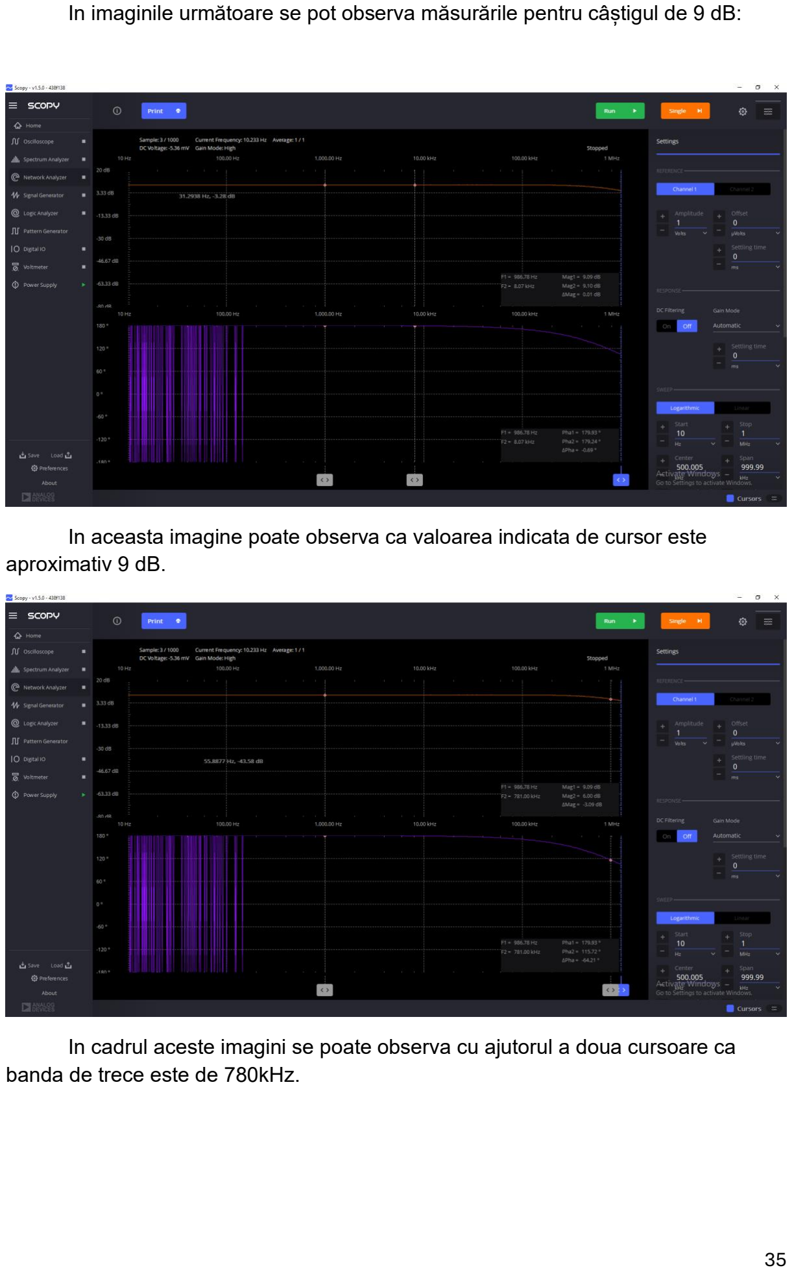
[picture p37: page 35]

In imaginile următoare se pot observa măsurările pentru câștigul de 9 dB:

In aceasta imagine poate observa ca valoarea indicata de cursor este aproximativ 9 dB.

In cadrul aceste imagini se poate observa cu ajutorul a doua cursoare ca banda de trece este de 780kHz.

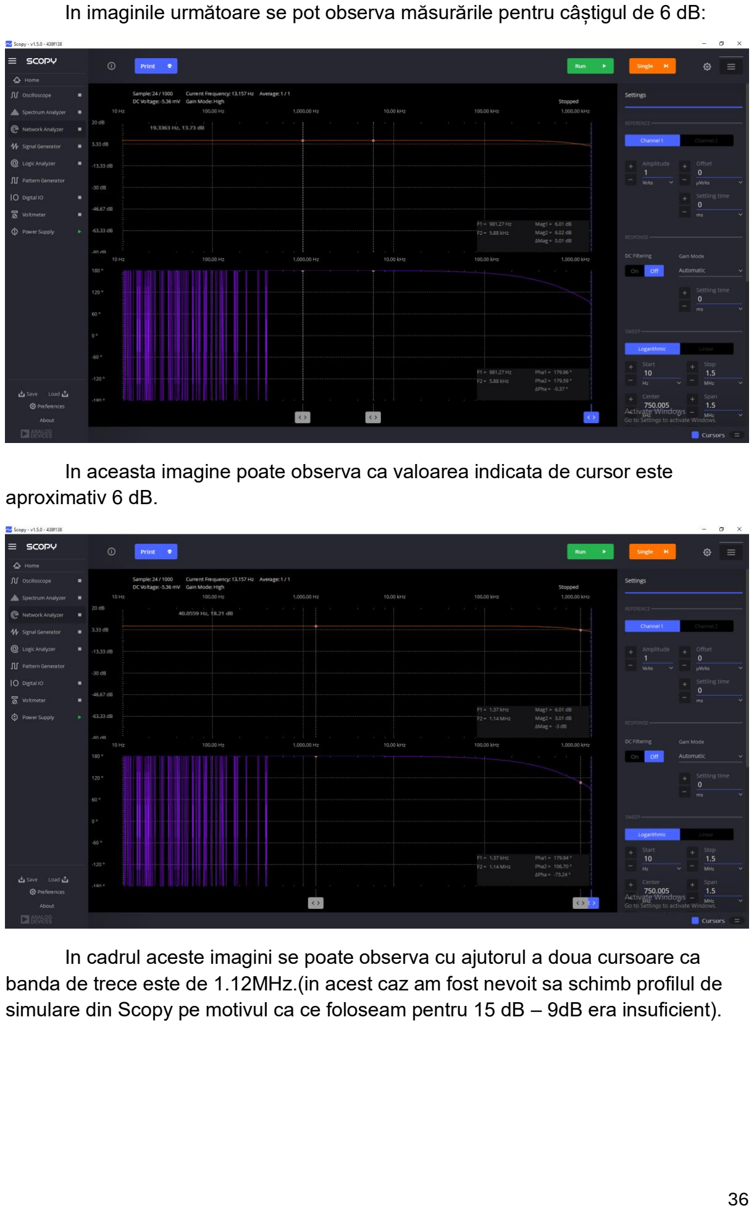
[picture p38: page 36]

In imaginile următoare se pot observa măsurările pentru câștigul de 6 dB:

In aceasta imagine poate observa ca valoarea indicata de cursor este aproximativ 6 dB.

In cadrul aceste imagini se poate observa cu ajutorul a doua cursoare ca banda de trece este de 1.12MHz.(in acest caz am fost nevoit sa schimb profilul de simulare din Scopy pe motivul ca ce foloseam pentru 15 dB – 9dB era insuficient).

4.4.Etajul 4

Din nefericire in cazul etajului 4 , deși după zile ce încercare nu am putut sa realizez circuitul fizica sa fie funcțional încât sa pot realiza măsurătorile necesare.

## 5.Concluzii

Tabele de comparație:

### Etaj 1

| Măsurat | Specificații
Slew-Rate | 59V/µs | 60 V/µs
Banda | | 4.3 MHz

Etaj2
| Măsurat | Specificații
Câștig | 0 dB | 0 dB
Banda | 1 kHz | 1 kHz

Etaj 3
Câștig | Banda
| Măsurat | Specificații | | Măsurat | Specificații
15 dB | 14.84 dB | 15 dB | 15 dB | 428 kHz | 645 kHz
12dB | 11.99 dB | 12 dB | 12 dB | 564 kHz | 912 kHz
9 dB | 9.09 dB | 9 dB | 9 dB | 780 kHz | 1.4 MHz
6 dB | 6.01 db | 6 dB | 6 dB | 1.12 MHz | 2.36 MHz

Etaj 4
| Măsurat | Specificații
Funcție de implementare

Pe parcursul realizării acestei lucrări de proiect am întâmpinat mai multe obstacole , cel mai important obstacol a fost chiar la început deoarece am fost nevoit sa lucrez cu un al amplificator operațional decât cel dat din specificații , dar după mai multe căutări am folosit cel mai apropiat amplificator pe care îl aveam de cel pe care trebuia sa îl folosesc.

Un alt mare obstacol a fost etajul 4 , in cadrul realizării practice pe parcursul a mai multe zile am încercat sa realizez circuitul dar fără succes , acest lucru făcând realizarea măsurătorilor imposibila .

Am putea considera un impediment statul de îmbătrânire a componentelor fizice , acest lucru făcând ca rezultatele măsurate sa nu fie exact ca cele din simulare .
