Madaul22/Analog-Voltage-Stabilizer/measurements_data/Etaj 1/Etaj1_ss1_ptGain.PNG

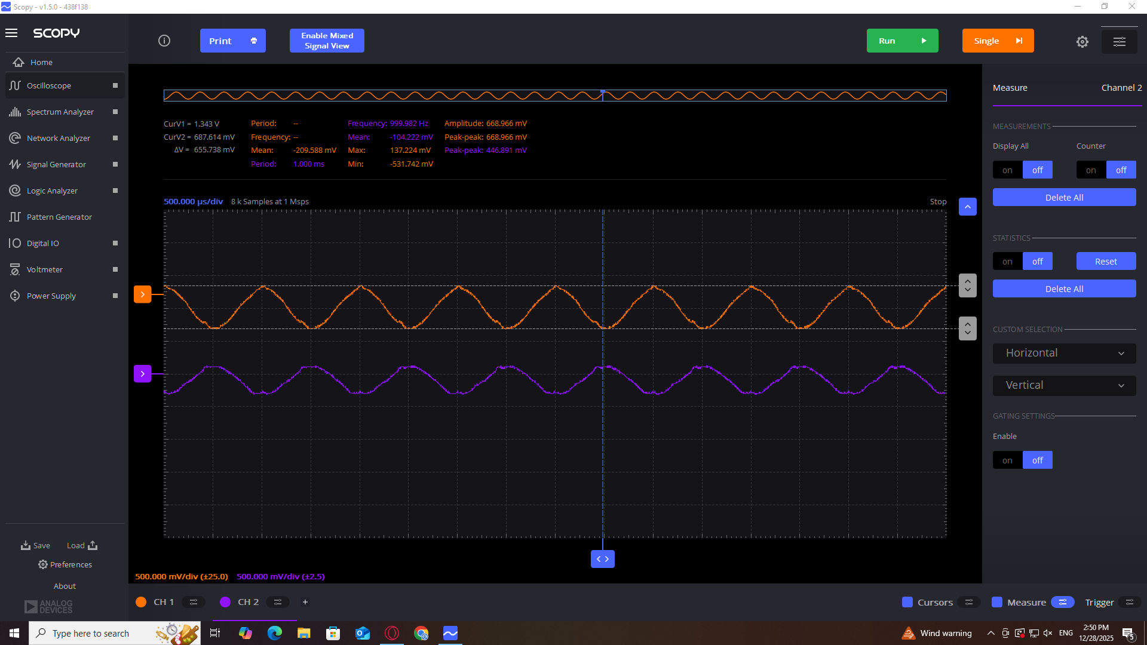
measurements_data/Etaj 1/Etaj1_ss1_ptGain.PNG
