Madaul22/Analog-Voltage-Stabilizer/measurements_data/Etaj 1/Etaj1_ss2_ptBandaDeFrecventa_100k.PNG

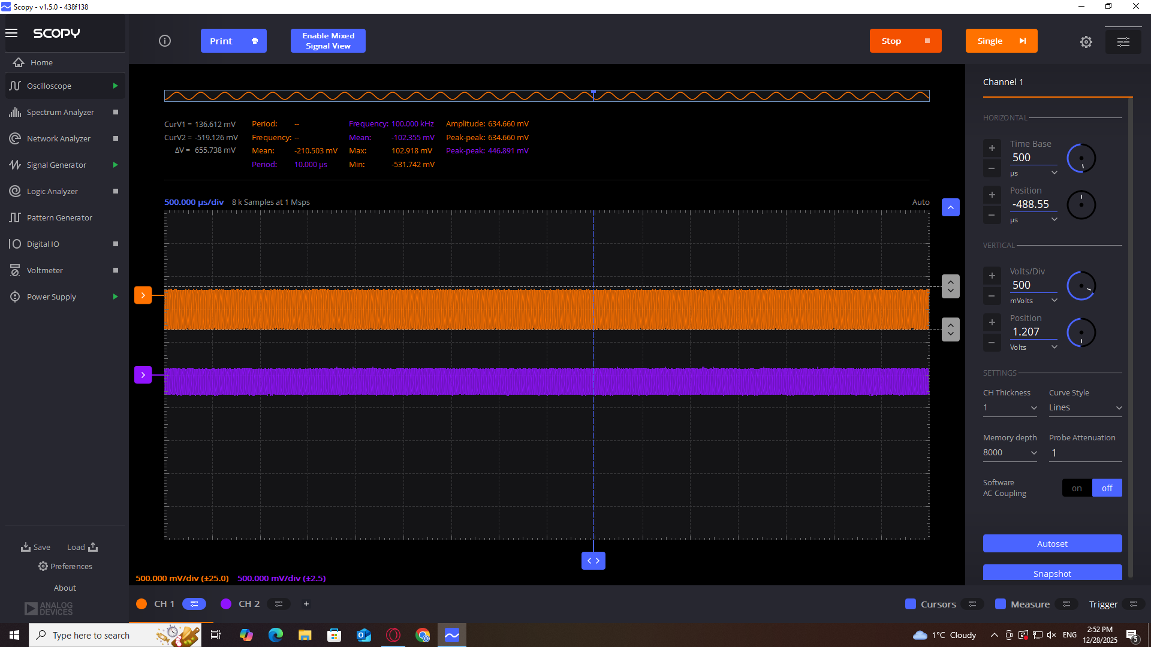
measurements_data/Etaj 1/Etaj1_ss2_ptBandaDeFrecventa_100k.PNG
