Madaul22/Analog-Voltage-Stabilizer/measurements_data/Etaj 1/Etaj1_ss3_SR.PNG

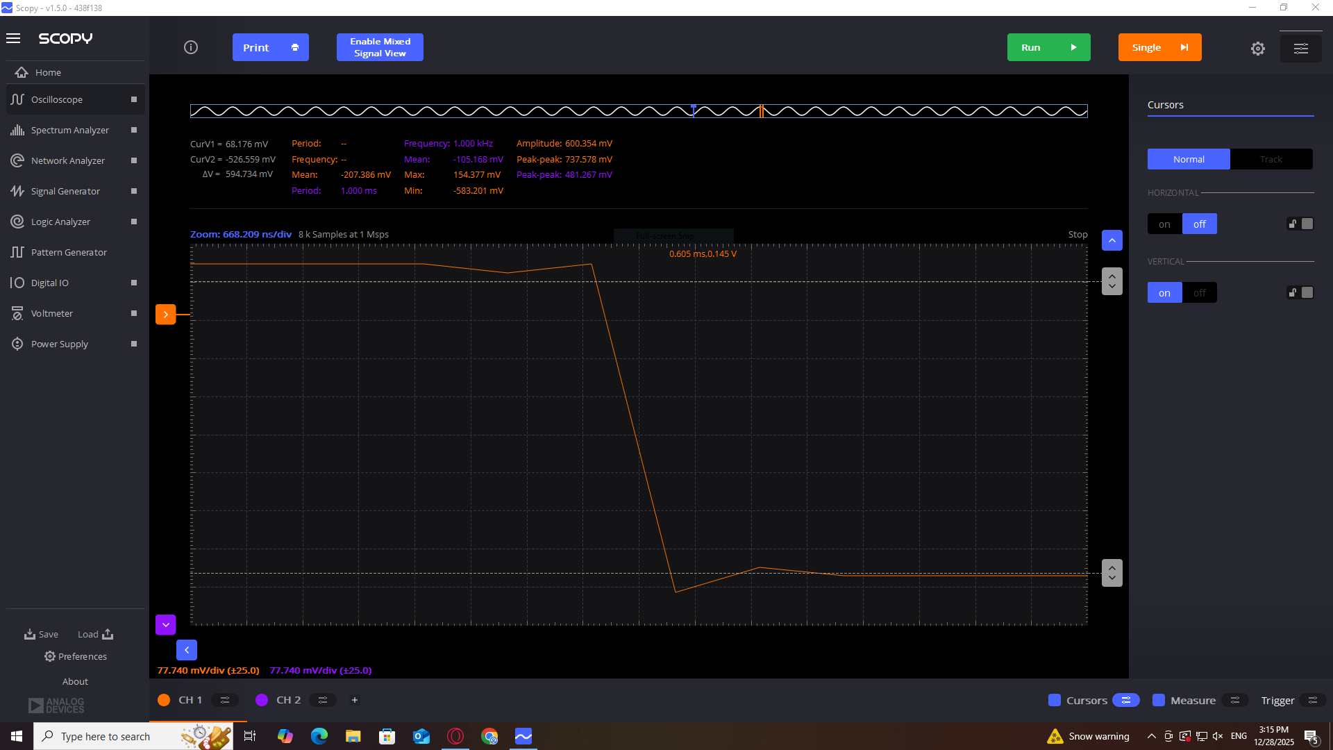
measurements_data/Etaj 1/Etaj1_ss3_SR.PNG
