Madaul22/Analog-Voltage-Stabilizer/measurements_data/Etaj 2/Etaj2_castig.PNG

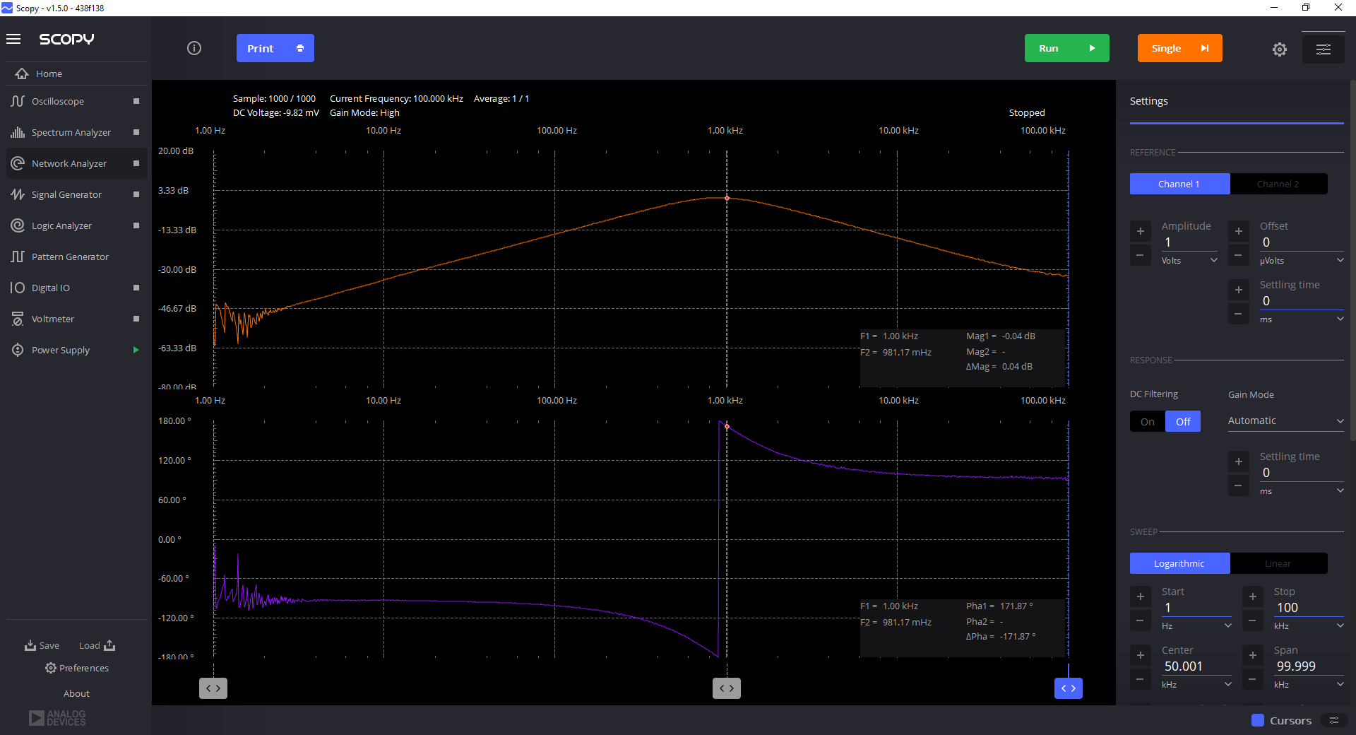
measurements_data/Etaj 2/Etaj2_castig.PNG
