Madaul22/Analog-Voltage-Stabilizer/measurements_data/Etaj 3/Etaj3_banda9dB.PNG

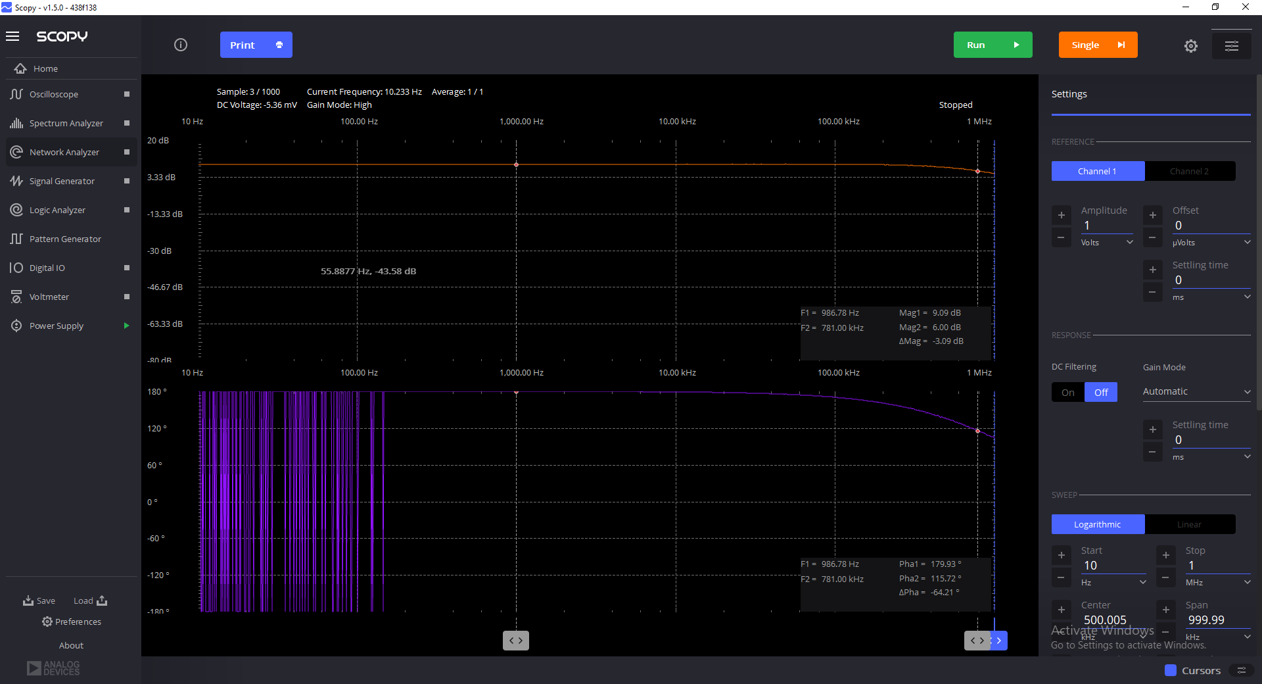
measurements_data/Etaj 3/Etaj3_banda9dB.PNG
