Madaul22/Analog-Voltage-Stabilizer/measurements_data/Etaj 3/Etaj3_banda12dB.PNG

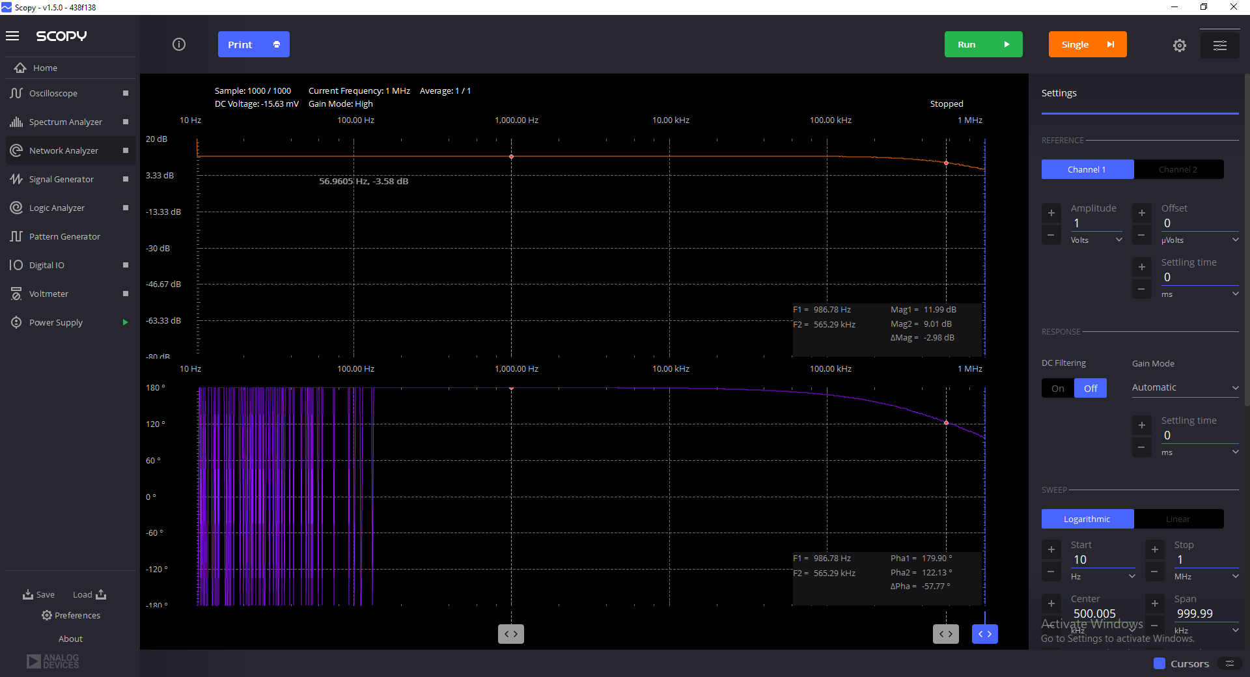
measurements_data/Etaj 3/Etaj3_banda12dB.PNG
