Madaul22/Analog-Voltage-Stabilizer/ltspice_files/Draft1.asc

R1: Res
R2: Res
V1: voltage
Named nets: 0
