Madaul22/Analog-Voltage-Stabilizer/ltspice_files/Draft2.asc

R1: Res; 10k
R2: Res; 15k
R3: Res; {Rtot*poz}
R4: Res; {Rtot*(1-poz)}
Rc1: Res; 10k
Rc2: Res; 10k
Rc: Res; 6k
U1: AD8065
V1: voltage; 15
V2: voltage; -15
Vin: Voltage; SINE(0 0.415 1k)
Named nets: 0, VCC, -VCC, Vout, Vin
.param Rtot=10k poz=0.519
.tran 5m
