Madaul22/Analog-Voltage-Stabilizer/ltspice_files/Draft3.asc

-VCC: Voltage; -5V
C1: Cap; 100n
C2: Cap; 100n
R1: Res; 1.6k
R2: Res; 3.18k
U1: OP482
VCC: Voltage; 5V
Vin: Voltage; SINE(0 1); AC 1
Named nets: 0, Vout, Vin, VCC, -VCC
.ac dec 100 10  100k
