Madaul22/Analog-Voltage-Stabilizer/ltspice_files/Draft4.asc

-VCC: Voltage; -5V
R2: Res; 22k
R3: Res; 33k
R4: Res; 47k
R5: Res; 18.5k
Rg: Res; 3.3k
S1: sw; SW_PGA
S2: sw; SW_PGA
S3: sw; SW_PGA
S4: sw; SW_PGA
U1: OP482
V1: Voltage; SINE(0 0.5 100); AC 1
VCC: Voltage; 5V
Vctrl: Voltage; 1V
Named nets: 0, VCC, -VCC, Vctrl, Vout, Vin
.model SW_PGA sw(Ron=0.1 Roff=100Meg Vt=0.5)
.op
.ac dec 100 10 1meg
.step param tensiune 0.4 1.2 0.8
.tran 0 50m 0 0.1m
.four 100 V(Vout)
