Madaul22/Analog-Voltage-Stabilizer/ltspice_files/Etaj1_proiectScia.asc

R1: Res; 10k
R2: Res; 15k
R3: Res; {Rtot*poz}
R4: Res; {Rtot*(1-poz)}
Rc1: Res; 10k
Rc2: Res; 10k
Rc: Res; 6k
U2: OP482
V1: voltage; 5
V2: voltage; -5
Vin: Voltage; SINE(0 0.415 1k); AC 1
Named nets: 0, VCC, -VCC, Vout, Vin
.param Rtot=10k poz=0.555
.tran 5m;
.op
.ac dec 100 1 10meg
.four 100 V(Vout)
