Madaul22/Analog-Voltage-Stabilizer/ltspice_files/Etaj4.asc

-VCC: Voltage; -5V
C1: Cap; 1µF
D1: diode; 1N4148
D2: diode; 1N4148
R1: Res; 20K
R2: Res; 20K
R3: Res; 100K
R4: Res; 200K
R5: Res; 220K
U1: OP482
U2: OP482
VCC: Voltage; 5V
Vin: Voltage; SINE(0 1 100)
Named nets: 0, Vout, Vin, VCC, -VCC
.tran 0 2 0 1m
.op
