Madaul22/Analog-Voltage-Stabilizer/ltspice_files/Etaj4_dc_sweep.asc

-VCC: Voltage; -5V
C1: Cap; 1µF
D1: diode; 1N4148
D2: diode; 1N4148
R1: Res; 20k
R2: Res; 20k
R3: Res; 100k
R4: Res; 200k
R5: Res; 220k
U1: OP482
U2: OP482
VCC: Voltage; 5V
Vin: Voltage; 0
Named nets: 0, VCC, -VCC, Vout, Vin
.dc Vin -2 2 0.01
